Kamerton/Kamerton5_0/README.md

# Kamerton5_0 

Проект тестирования модуля Камертон
