Kamerton/Kamerton5_0/Adio1-v5Csch.pdf

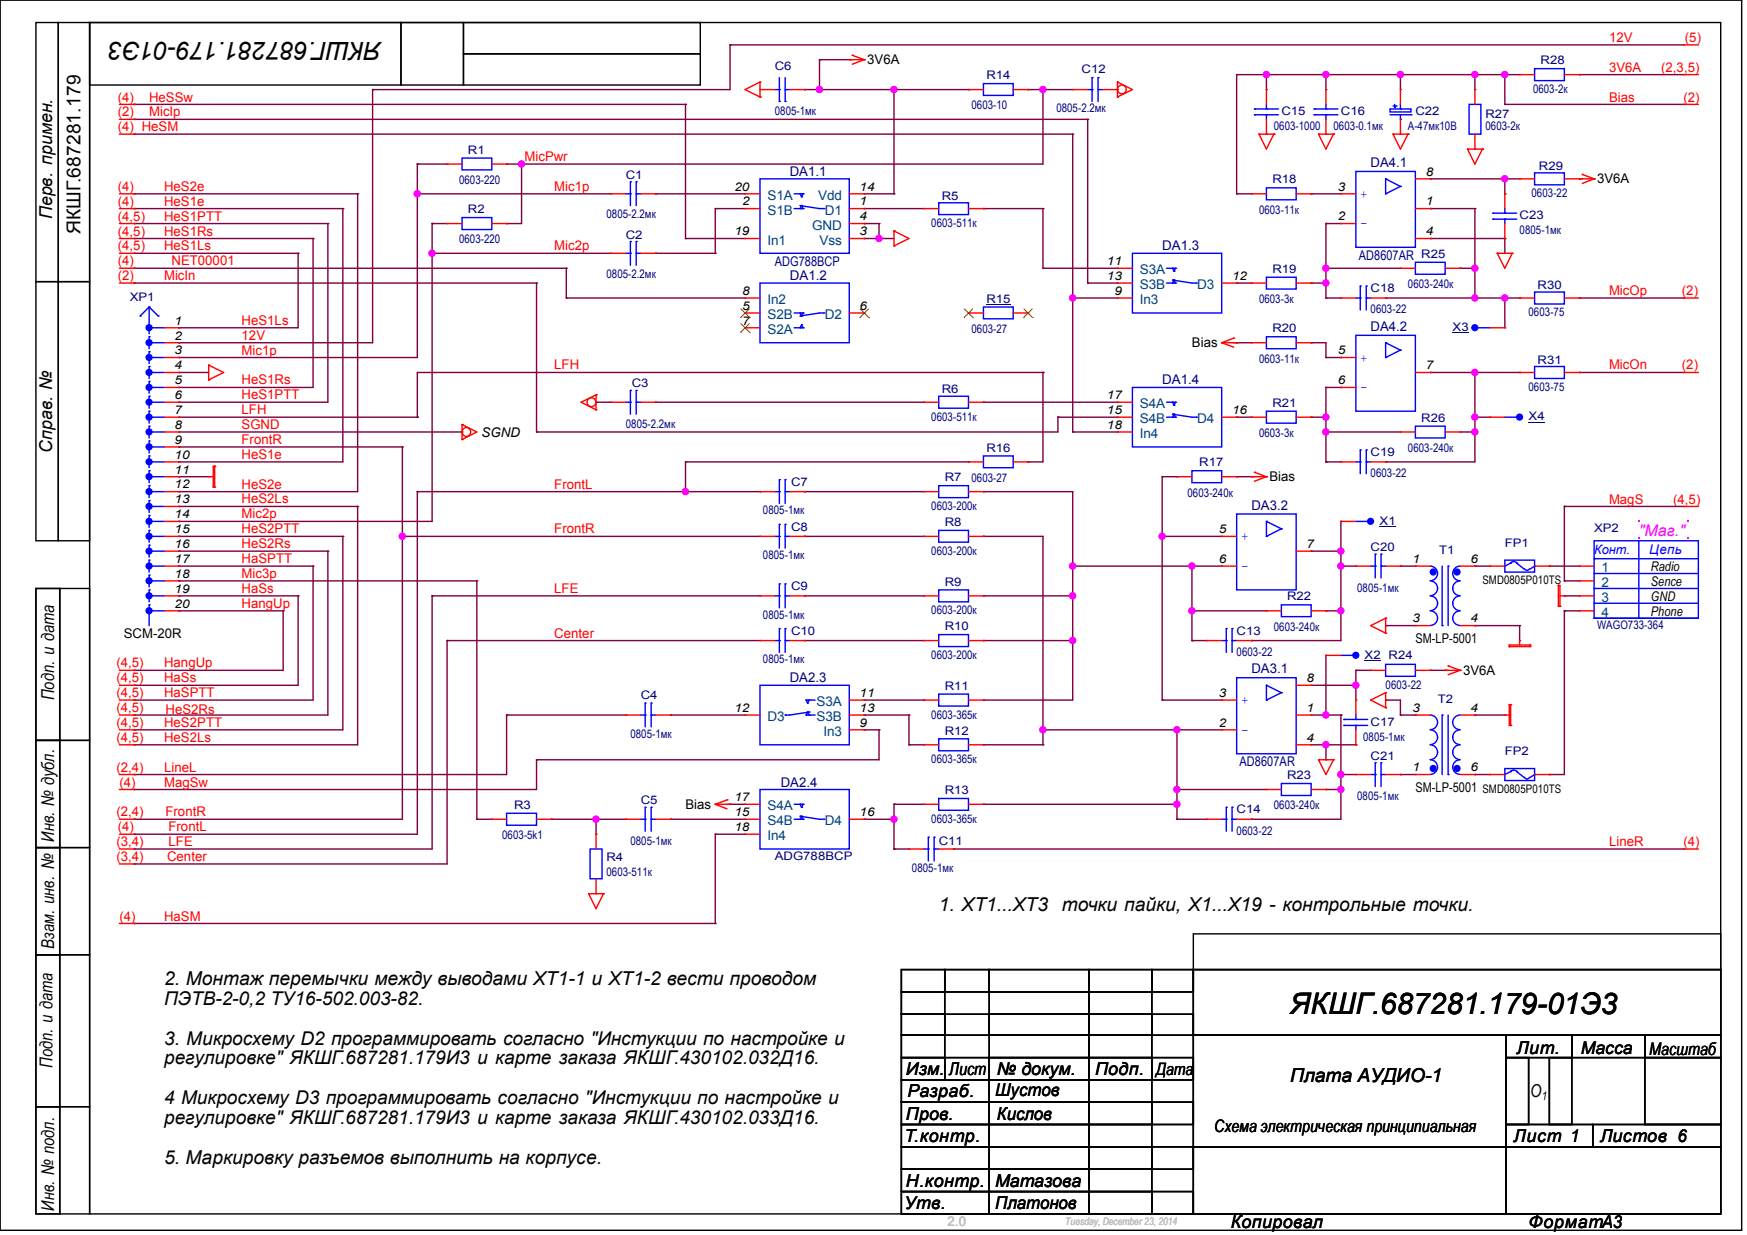
[picture p13: page 1]

Подп. и дата Инв. № дубл. Взам. инв. № Инв. № подл. Подп. и дата

1. XT1...XT3 точки пайки, Х1...Х19 - контрольные точки.

2. Монтаж перемычки между выводами XT1-1 и ХТ1-2 вести проводом
ПЭТВ-2-0,2 ТУ16-502.003-82.

3. Микросхему D2 программировать согласно "Инстукции по настройке и
регулировке" ЯКШГ.687281.179И3 и карте заказа ЯКШГ.430102.032Д16.

4 Микросхему D3 программировать согласно "Инстукции по настройке и
регулировке" ЯКШГ.687281.179И3 и карте заказа ЯКШГ.430102.033Д16.

5. Маркировку разъемов выполнить на корпусе.

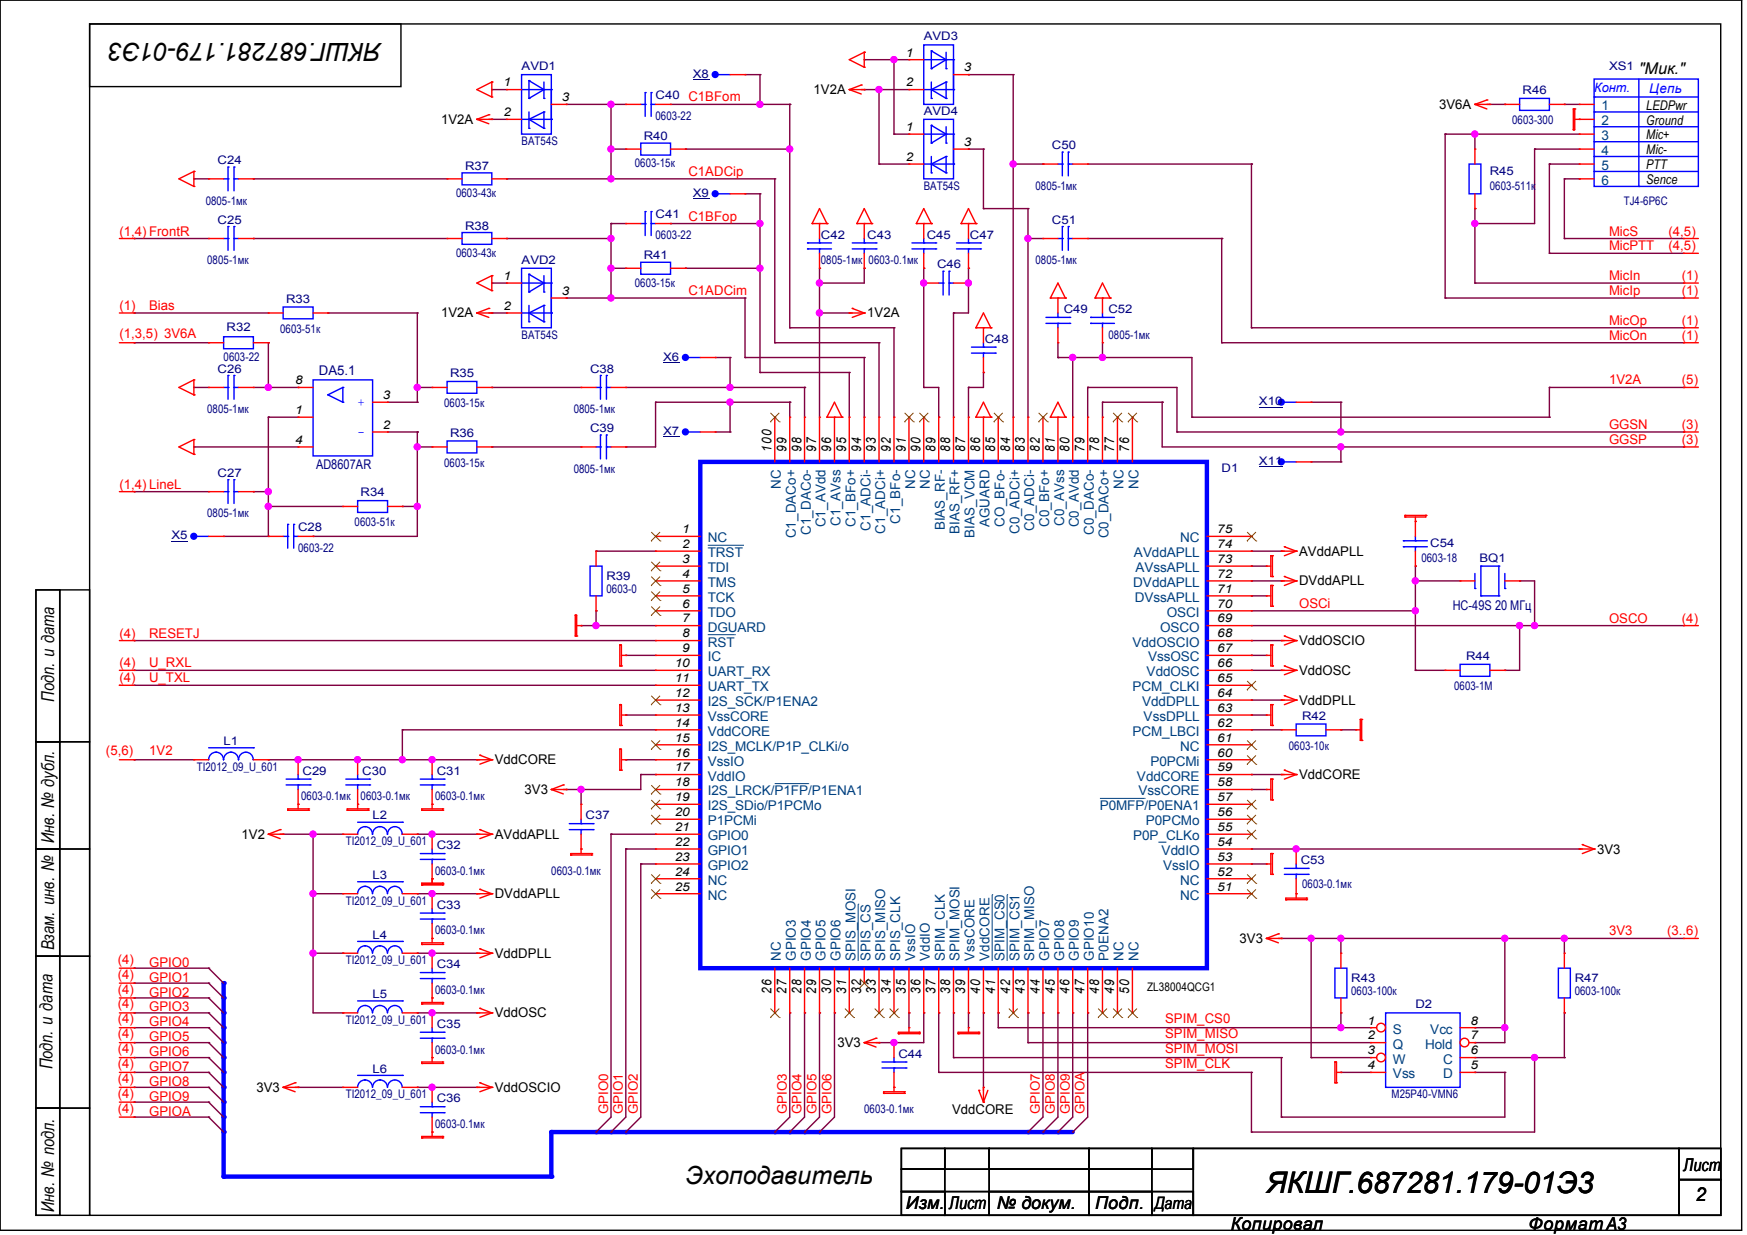
[picture p14: page 2]

Подп. и дата Инв. № дубл. Взам. инв. № Инв. № подл. Подп. и дата

Изм. Лист № докум. Подп. Дата

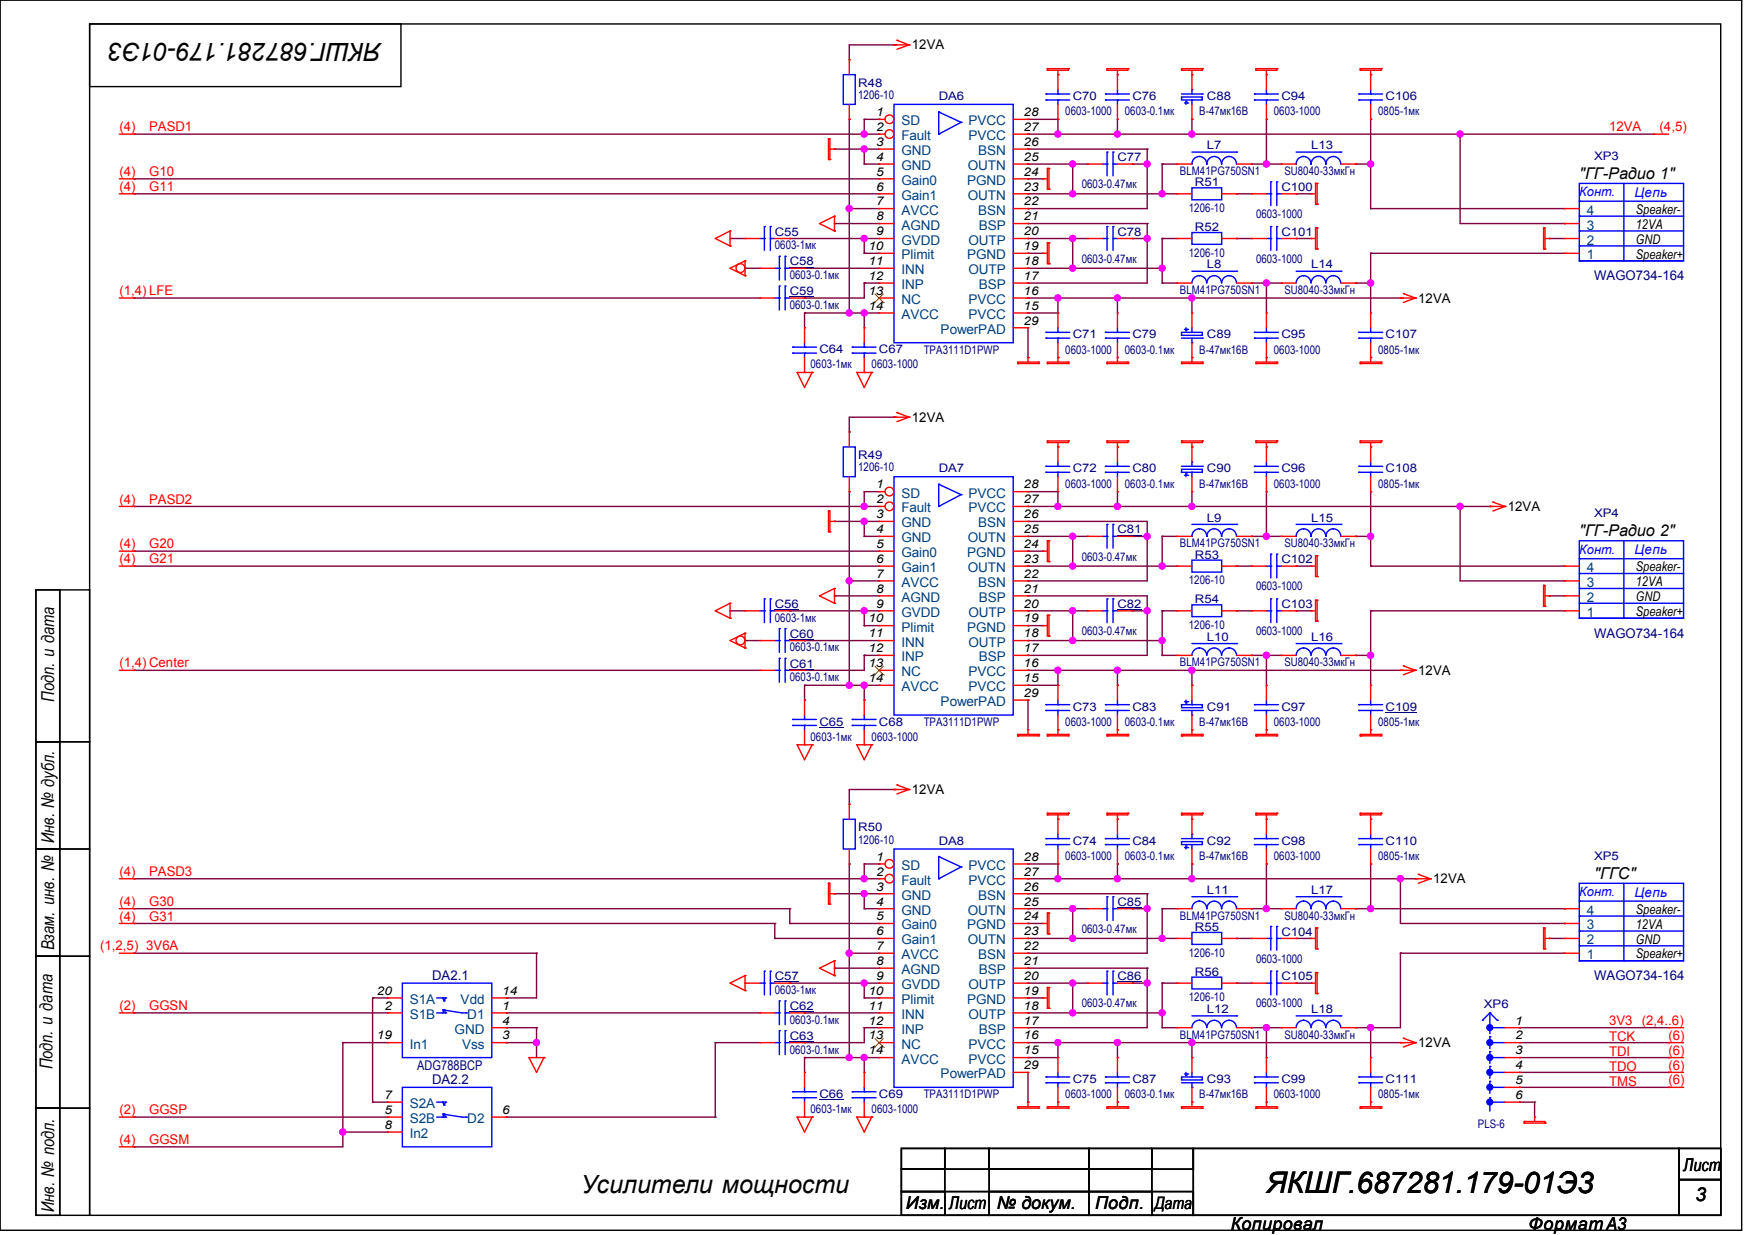
[picture p15: page 3]

Подп. и дата Инв. № дубл. Взам. инв. № Инв. № подл. Подп. и дата

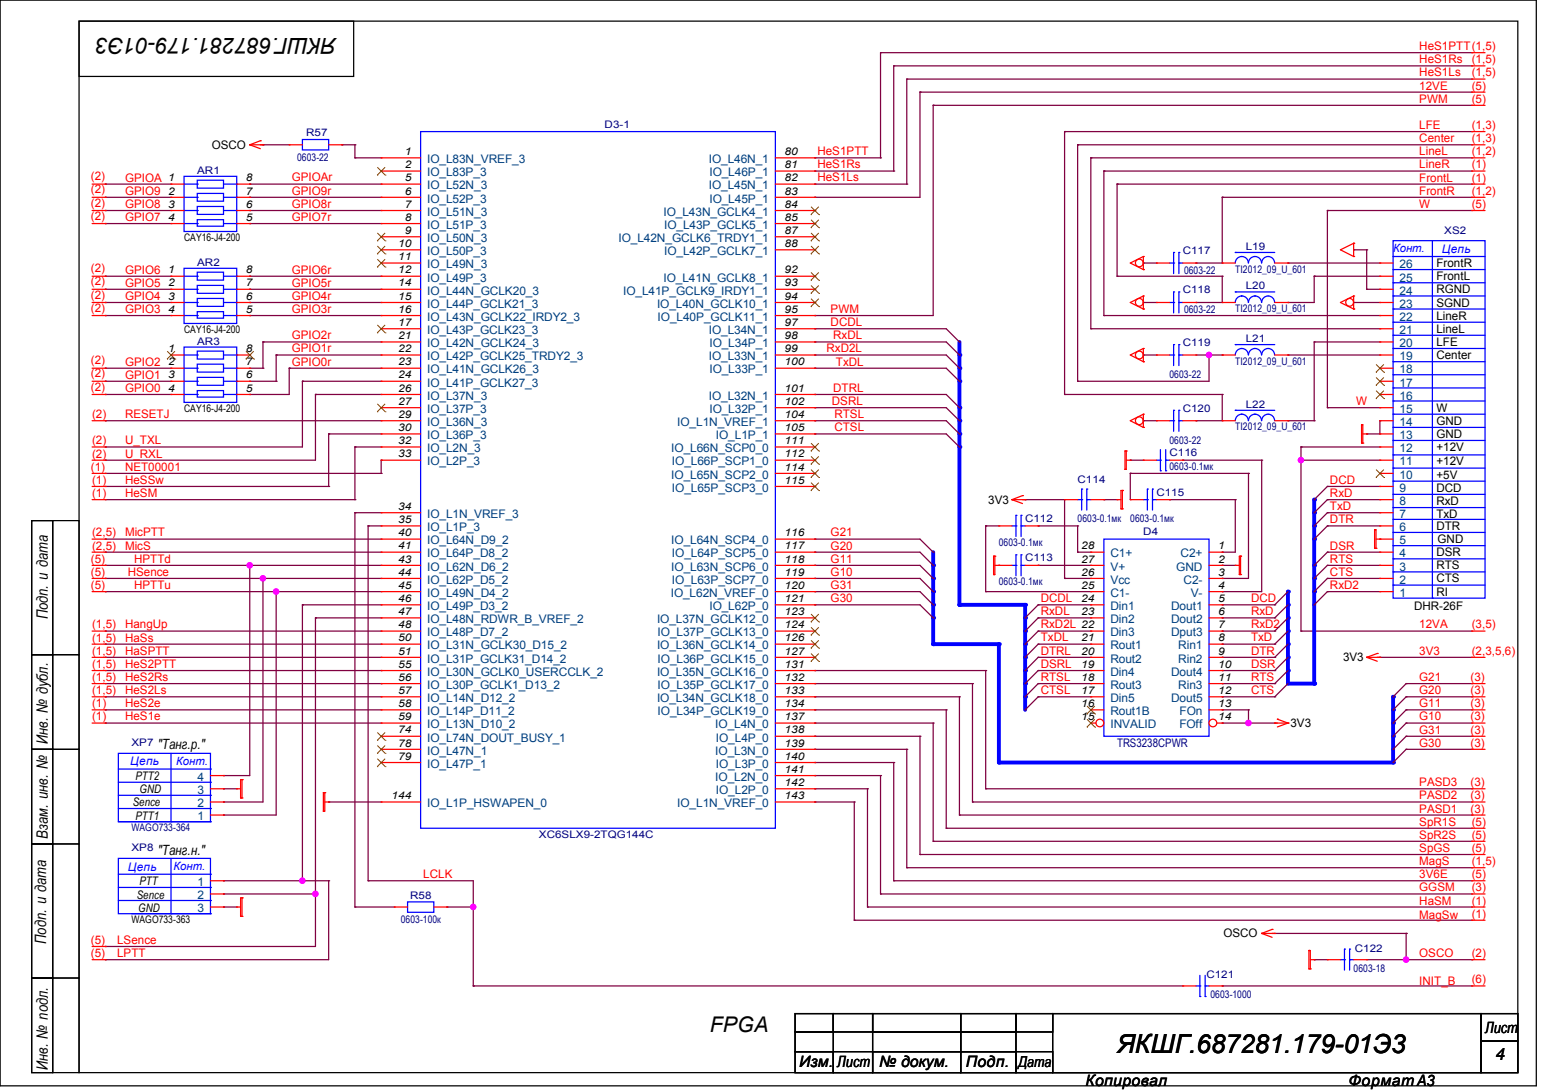
[picture p16: page 4]

Подп. и дата Инв. № дубл. Взам. инв. № Инв. № подл. Подп. и дата

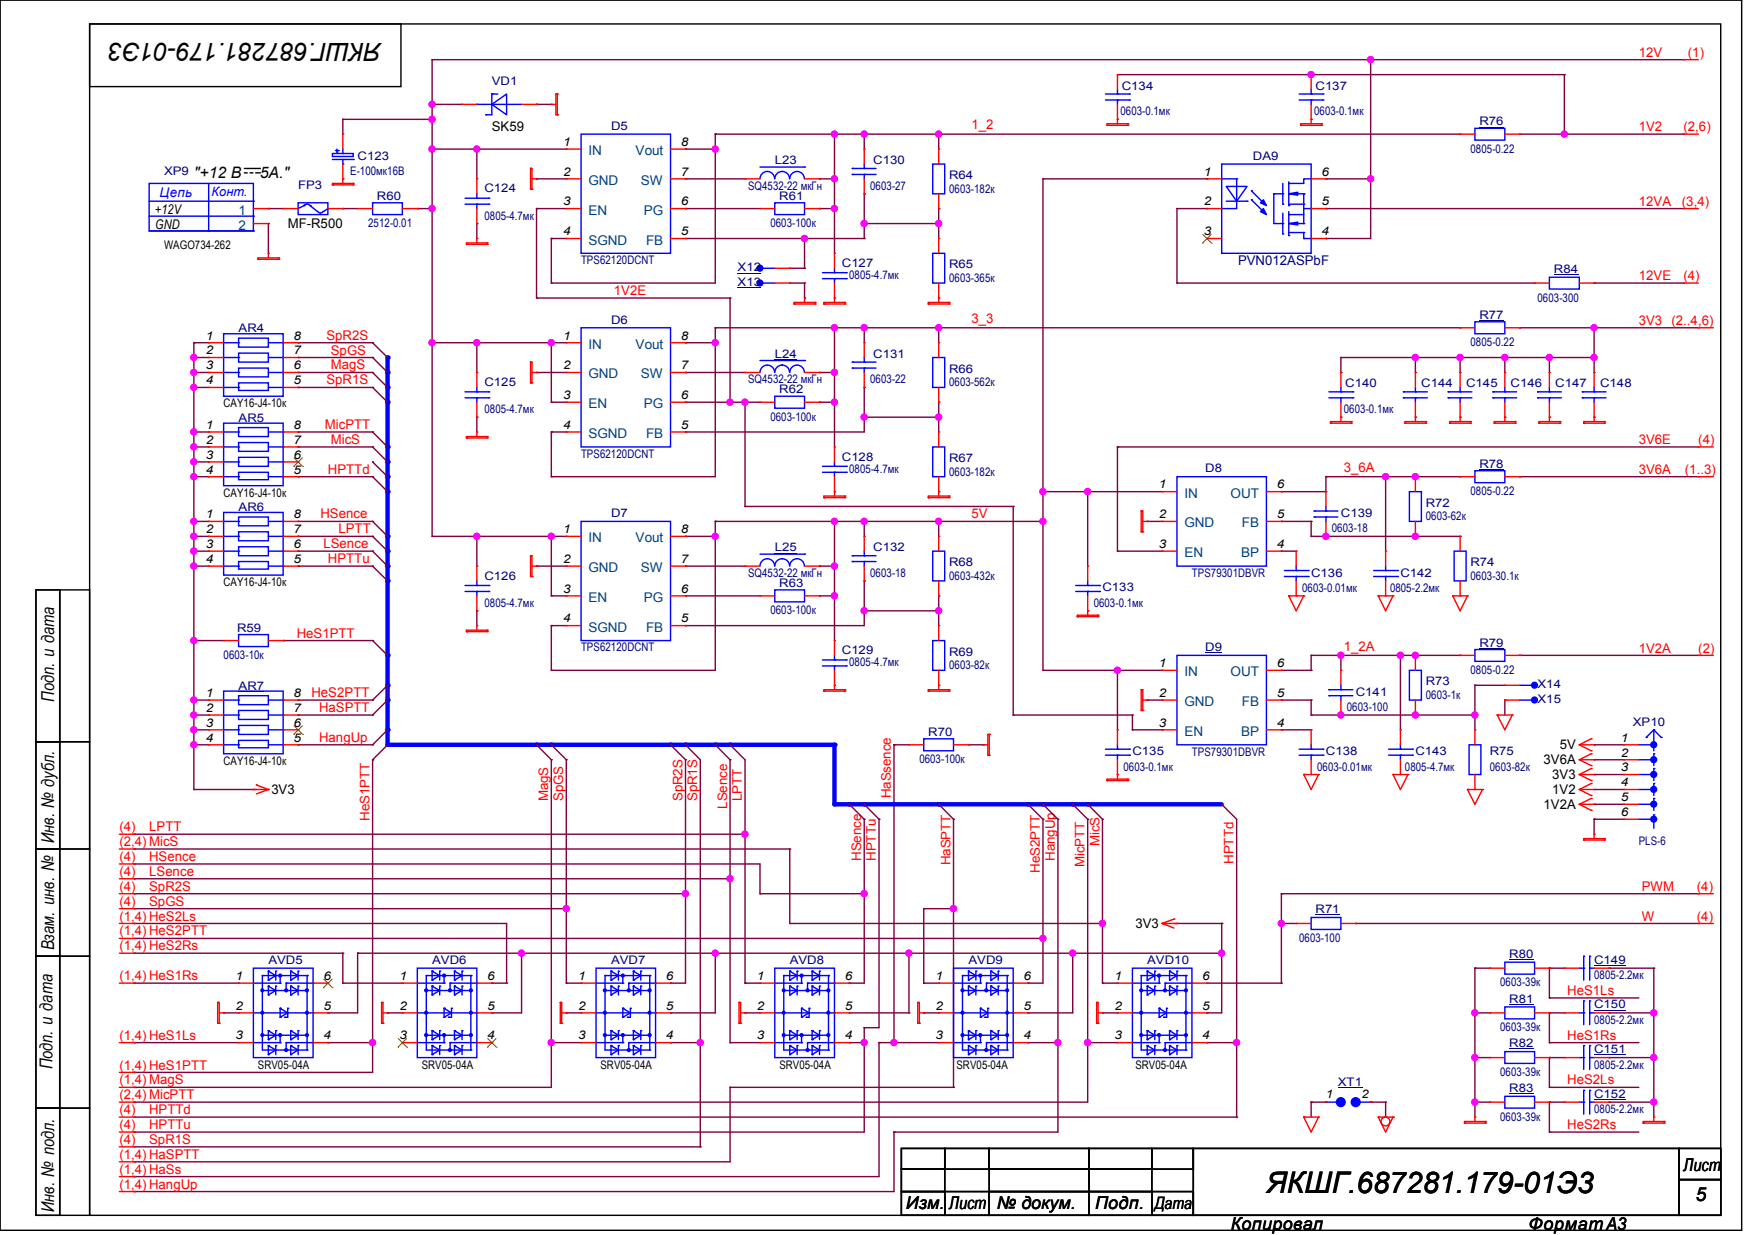
[picture p17: page 5]

Подп. и дата Инв. № дубл. Взам. инв. № Инв. № подл. Подп. и дата

1 | 1 | SPI_slave
XT1 | XT2

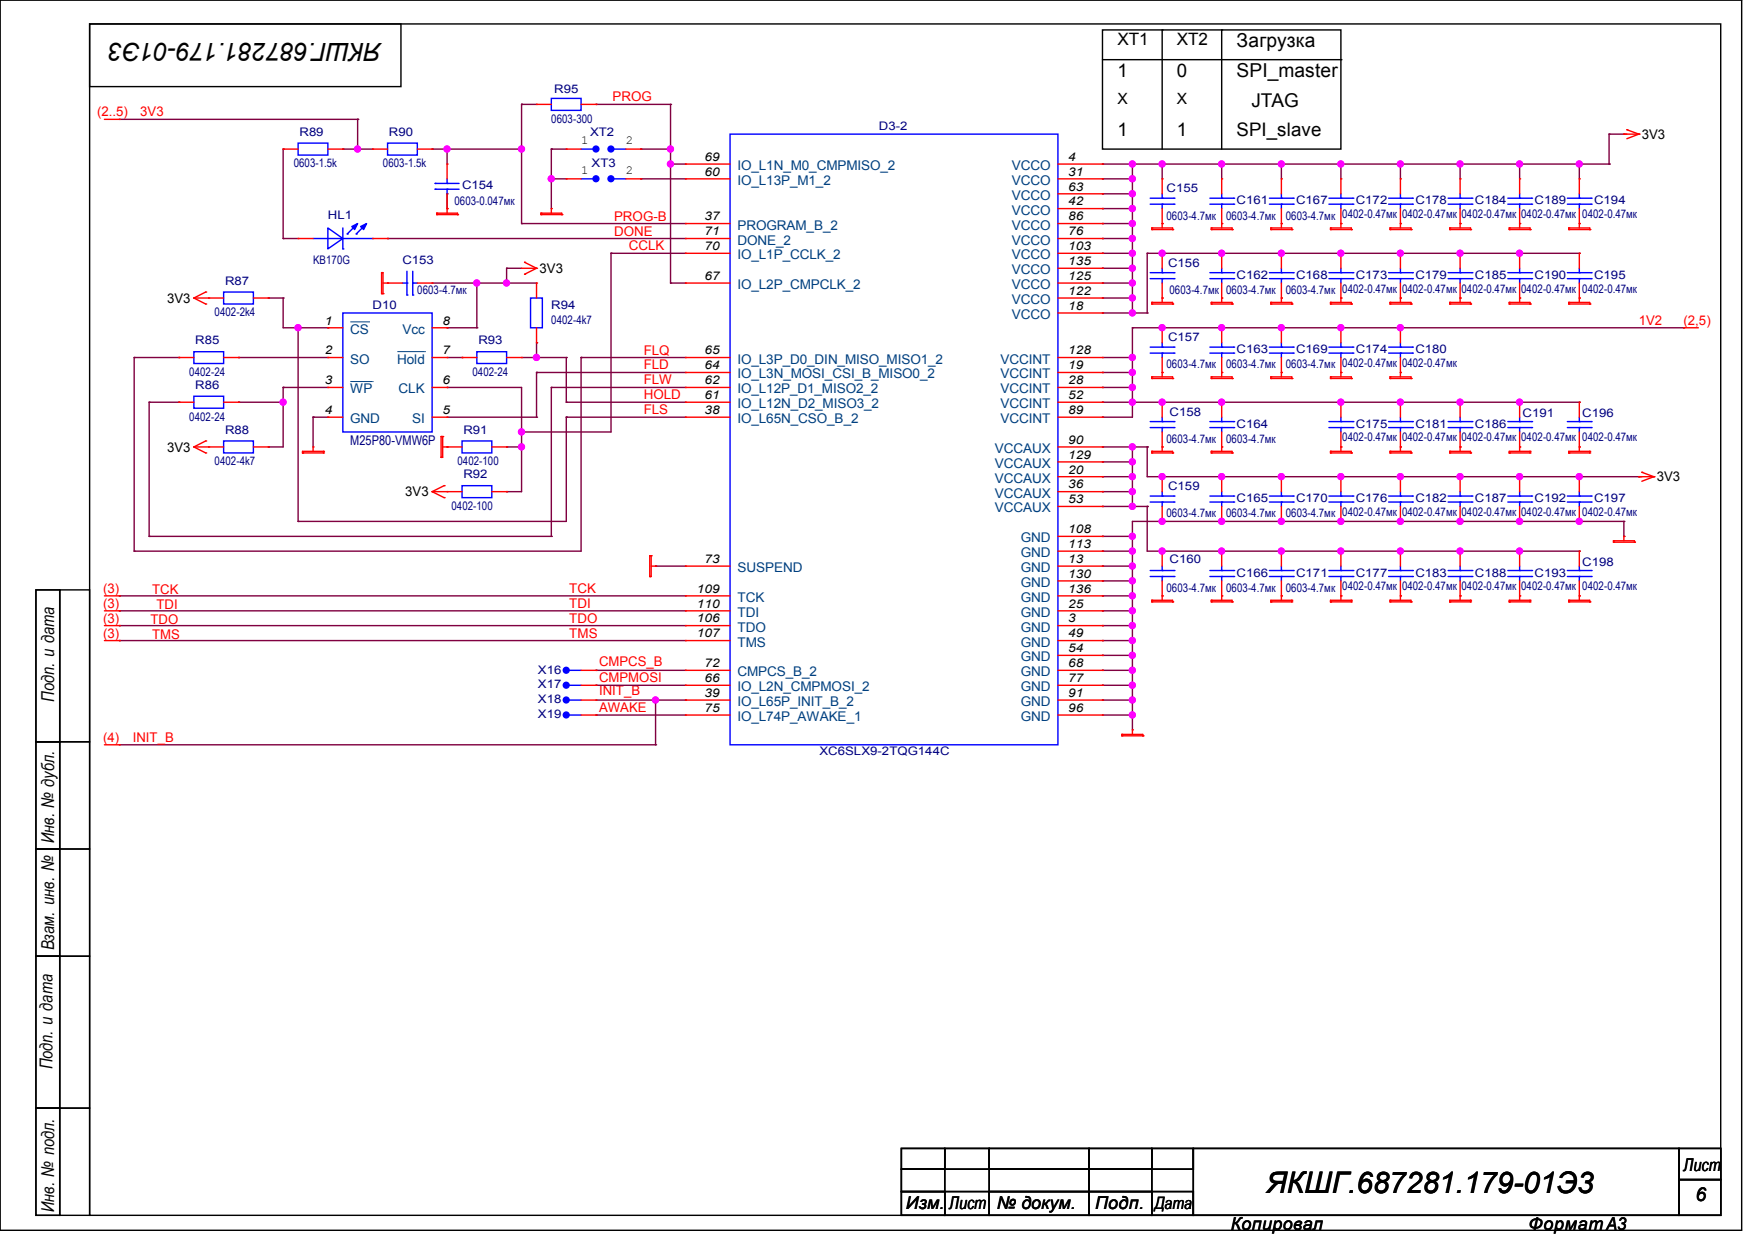
[picture p18: page 6]

Подп. и дата Инв. № дубл. Взам. инв. № Инв. № подл. Подп. и дата

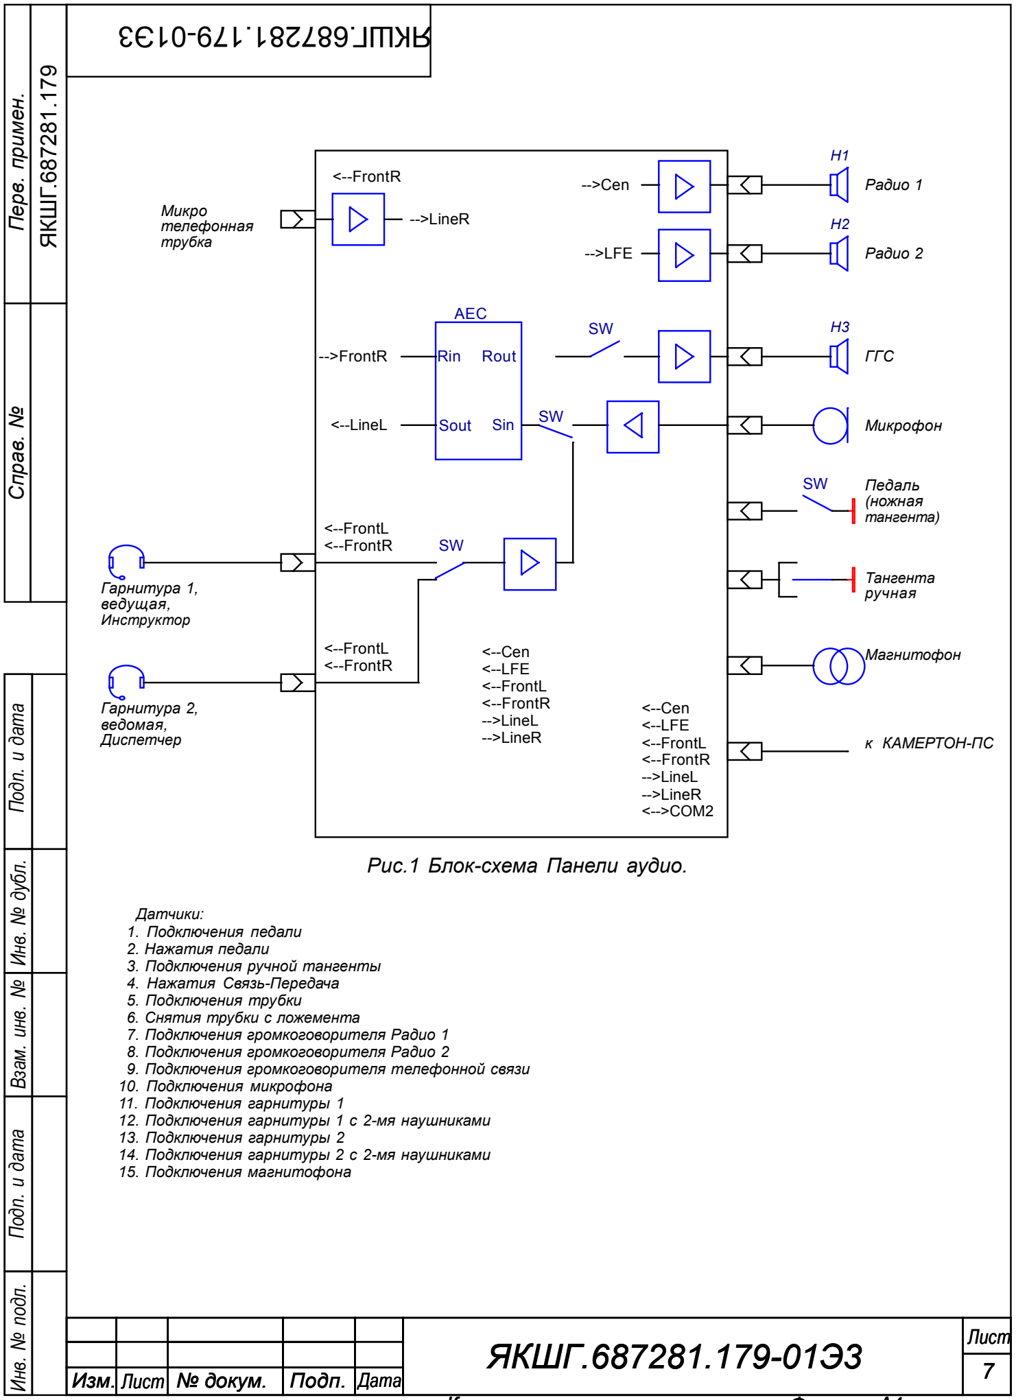
[picture p19: figure]
ЯКШГ.687281.179; -->LineL; <--FrontL <--FrontR; -->LineR; <--LFE; <--Cen; <-->COM2; -->Cen; -->LFE; <--LineL; -->FrontR; <--FrontR; Рис.1 Блок-схема Панели аудио.; Радио 1; Радио 2; ГГС; Микрофон; Магнитофон; Тангента ручная; Педаль (ножная тангента); к КАМЕРТОН-ПС; Микро телефонная трубка; Гарнитура 1, ведущая, Инструктор; Гарнитура 2, ведомая, Диспетчер; Rin; Rout; Sout; Sin; AEC; 15. Подключения магнитофона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

## Перв. примен. Справ. № Подп. и дата Инв. № дубл. Взам. инв. № Инв. № подл. Подп. и дата

9. Подключения громкоговорителя телефонной связи
12. Подключения гарнитуры 1 с 2-мя наушниками
14. Подключения гарнитуры 2 с 2-мя наушниками
