Kamerton/Kamerton5_0/(list of files, drawings)

Other design files:
Proteus Kamerton5_0/Mega2560 Kamerton5_0.pdsprj
Proteus Kamerton5_0/Mega2560 Kamerton5_1.pdsprj
Proteus Kamerton5_0/Mega2560 Kamerton5_2.pdsprj
Proteus Kamerton5_0/Mega2560 Kamerton5_3.pdsprj
Proteus Kamerton5_0/Mega2560 Kamerton5_4.pdsprj
Proteus Kamerton5_0/Mega2560 Kamerton5_5.pdsprj
Proteus Kamerton5_5mod/Mega2560 Kamerton5_5_mod.pdsprj
