Kamerton/Kamerton5_0/Kamerton5_0/Kamerton5_0.ino

/*

 Kamerton5_0.ino
 VisualStudio
 
 Программа тестирования модуля "Камертон" (Базовый вариант)
 Версия:      - 5_0
 Дата:        - 13.11.2015г.
 Организация: - ООО "Децима"
 Автор:       - Мосейчук А.В.
 Версия: Обновленная версия от 17.09.2015г. Новая плата с учетом добавления 
 высоковольтного  модуля для испытания на пробой.
 Реализовано:
 -
 - прерывание 30мс,
 - передача/прием по СОМ порту,
 - подсчет контролных сумм, связь с Камертоном, 
 - Расширение MCP23017
 - модуль реле, 
 - чтение всех портов, 
 - подключен звуковой генератор
 - Подключена SD память
 - подключены часы, память, 
 */


#include <SPI.h>
#include <SdFat.h>
#include <SdFatUtil.h>
#include <Wire.h> 
#include <RTClib.h>
#include <MsTimer2.h> 
#include <modbus.h>
#include <modbusDevice.h>
#include <modbusRegBank.h>
#include <modbusSlave.h>
#include "MCP23017.h"
#include <avr/pgmspace.h>
#include <AH_AD9850.h>
#include <avr/wdt.h>



//CLK - D6, FQUP - D7,  BitData - D8, RESET - D9
//AH_AD9850(int CLK, int FQUP, int BitData, int RESET);
//AH_AD9850 AD9850(6, 7, 8, 9);
AH_AD9850 AD9850(23, 25, 27, 29);


#define  ledPin13  13                               // Назначение светодиодов на плате
#define  ledPin12  12                               // Назначение светодиодов на плате
#define  ledPin11  11                               // Назначение светодиодов на плате
#define  ledPin10  10                               // Назначение светодиодов на плате
#define  Front_led_Blue 14                          // Назначение светодиодов на передней панели
#define  Front_led_Red  15                          // Назначение светодиодов на передней панели

//+++++++++++++++++++++++++++++ Внешняя память +++++++++++++++++++++++++++++++++++++++
int deviceaddress        = 80;                      // Адрес микросхемы памяти
unsigned int eeaddress   =  0;                      // Адрес ячейки памяти
byte hi;                                            // Старший байт для преобразования числа
byte low;                                           // Младший байт для преобразования числа


//  Порты управления платой Камертон
#define DTR  8                                      // DTR out выходной сигнал  сформировать 0 для старта
#define RTS  9                                      // RTS out выходной сигнал   
#define CTS  5                                      // CTS in  входной сигнал  флаг нажатия тангенты контролировать!!!!
#define DSR  6                                      // DSR in  входной сигнал  флаг нажатия "Связь - передача"
#define DCD  7                                      // DCD in  входной сигнал  флаг снятия трубки с ложемента 


//  Порты управления платой Arduino Nano
#define  kn1Nano   34                               // Назначение кнопок управления Nano генератор качения
#define  kn2Nano   36                               // Назначение кнопок управления Nano генератор 1000 гц
#define  kn3Nano   38                               // Назначение кнопок управления Nano генератор 2000 гц
#define  InNano12  40                               // Назначение входов - индикация генератор 1000 или 2000 гц
#define  InNano13  39                               // Назначение входов - индикация генератор качения 




//+++++++++++++++++++++++ Настройка электронного резистора +++++++++++++++++++++++++++++++++++++
#define address_AD5252   0x2F                       // Адрес микросхемы AD5252  
#define control_word1    0x07                       // Байт инструкции резистор №1
#define control_word2    0x87                       // Байт инструкции резистор №2
byte resistance        = 0x00;                      // Сопротивление 0x00..0xFF - 0Ом..100кОм
//byte level_resist      = 0;                       // Байт считанных данных величины резистора
//-----------------------------------------------------------------------------------------------
unsigned int volume1     = 0;                       //
unsigned int volume_max  = 0;                       //
unsigned int volume_min  = 0;                       //
unsigned int volume_fact = 0;                       //
unsigned int Array_volume[260];                     //
unsigned int Array_min[40];                         //
unsigned int Array_max[40];                         //
unsigned int volume_porog_D = 40;                   // Максимальная величина порога при проверке исправности FrontL,FrontR
unsigned int volume_porog_L = 200;                  // Минимальная величина порога при проверке исправности FrontL,FrontR
float voltage ;
//float voltage_test = 0.60;                        // порог величины синусоиды звука
unsigned int  voltage10 ;
unsigned long number_audio = 0;   


#define FASTADC 1                                   // Ускорение считывания аналогового сигнала
// defines for setting and clearing register bits
#ifndef cbi
#define cbi(sfr, bit) (_SFR_BYTE(sfr) &= ~_BV(bit))
#endif
#ifndef sbi
#define sbi(sfr, bit) (_SFR_BYTE(sfr) |= _BV(bit))
#endif


//***************************** Назначение аналоговых входов   ****************************************
int analog_tok            = 0;       //   Измерение тока питания платы Камертон
int analog_12V            = 1;       //   Измерение напряжения питания 12в. платы Камертон
int analog_tok_x10        = 2;       //   Измерение тока питания платы Камертон х 10
int analog_mag_radio      = 3;       //
int analog_mag_phone      = 4;       //
int analog_gg_radio1      = 5;       //
int analog_gg_radio2      = 6;       //
int analog_ggs            = 7;       //
int analog_LineL          = 8;       //
int analog_LineR          = 9;       //
int analog_FrontL         = 10;       //
int analog_FrontR         = 11;       //
int analog_W              = 12;       //
int analog_13             = 13;       // Измерение напряжения питания  12в.на разъемах  платы Камертон
int analog_14             = 14;       // Измерение напряжения питания  12в.на разъемах  платы Камертон
int analog_3_6            = 15;       // Измерение напряжения питания 3,6в. на разъемах платы Камертон

//-----------------------------------------------------------------------------------
bool portFound = false;
byte inputByte_0;
byte inputByte_1;
byte inputByte_2;
byte inputByte_3;
byte inputByte_4;
uint32_t logTime = 0;
int32_t diff = 0;

bool blink_red = false;
//************************************************************************************************

RTC_DS1307 RTC;                                     // define the Real Time Clock object

//-----------------------------------------------------------------------------------------------

uint8_t second = 0;       //Initialization time
uint8_t minute = 0;
uint8_t hour   = 0;
uint8_t dow    = 1;
uint8_t day    = 1;
uint8_t month  = 1;
uint16_t year  = 15 ;

//------------------------------------------------------------------------------------------------------------
MCP23017 mcp_Out1;                                  // Назначение портов расширения MCP23017  4 A - Out, B - Out
MCP23017 mcp_Out2;                                  // Назначение портов расширения MCP23017  6 A - Out, B - Out
MCP23017 mcp_Analog;                                // Назначение портов расширения MCP23017  5 A - Out, B - In
//----------------------------------------------------------------------------------------------
const int adr_reg_ind_CTS      PROGMEM           = 10081;        // Адрес флагa индикации состояния сигнала CTS
const int adr_reg_ind_DSR      PROGMEM           = 10082;        // Адрес флагa индикации состояния сигнала DSR
const int adr_reg_ind_DCD      PROGMEM           = 10083;        // Адрес флагa индикации состояния сигнала DCD

// **************** Адреса внешней памяти для хранения даты. Применяется приформировании имени файла *************
//const int adr_temp_day         PROGMEM           = 240;          // Адрес хранения переменной день
//const int adr_temp_mon         PROGMEM           = 241;          // Адрес хранения переменной месяц
//const int adr_temp_year        PROGMEM           = 242;          // Адрес хранения переменной год  
//const int adr_file_name_count  PROGMEM           = 243;          // Адрес хранения переменной счетчика номера файла
//------------------------------------------------------------------------------------------------------------------
int regcount_err        = 0;                                     // Переменная для хранения всех ошибок
	//	hi=highByte(n_str_electro);
	//	low=lowByte(n_str_electro);

//++++++++++++++++++++++ Работа с файлами +++++++++++++++++++++++++++++++++++++++
//#define chipSelect SS
#define chipSelect 49   // Основной
SdFat sd;
File myFile;
SdFile file;
//Sd2Card card;
//
//uint32_t cardSizeBlocks;
//uint16_t cardCapacityMB;
//
//// cache for SD block
//cache_t cache;


// созданы переменные, использующие функции библиотеки SD utility library functions: +++++++++++++++
// Change spiSpeed to SPI_FULL_SPEED for better performance
// Use SPI_QUARTER_SPEED for even slower SPI bus speed
const uint8_t spiSpeed = SPI_HALF_SPEED;


//++++++++++++++++++++ Назначение имени файла ++++++++++++++++++++++++++++++++++++++++++++
//const uint32_t FILE_BLOCK_COUNT = 256000;
// log file base name.  Must be six characters or less.
#define FILE_BASE_NAME "150101"
const uint8_t BASE_NAME_SIZE = sizeof(FILE_BASE_NAME) - 1;
char fileName[13]            = FILE_BASE_NAME "00.TXT";
char fileName_p[13];
char fileName_F[13];
//------------------------------------------------------------------------------

char c;  // Для ввода символа с ком порта

// Serial output stream
ArduinoOutStream cout(Serial);
char bufferSerial2[128];  

//*********************Работа с именем файла ******************************

//byte file_name_count = 0;
char str_day_file[3];
char str_day_file0[3];
char str_day_file10[3];
char str_mon_file[3];
char str_mon_file0[3];
char str_mon_file10[3];
char str_year_file[3];

char str0[10];
char str1[10];
char str2[10];

//+++++++++++++++++++++ Установки прерывания +++++++++++++++++++++++++++++++

unsigned int sampleCount1 = 0;

//+++++++++++++++++++ MODBUS ++++++++++++++++++++++++++++++++++++++++++++++++++++++++++

modbusDevice regBank;
//Create the modbus slave protocol handler
modbusSlave slave;

//byte regs_in[5];                                    // Регистры работы с платой Камертон CPLL
byte regs_out[4];                                   // Регистры работы с платой Камертон
byte regs_crc[1];                                   // Регистры работы с платой Камертон контрольная сумма
byte regs_temp = 0;
byte regs_temp1 = 0;
byte Stop_Kam = 0;                                  // Флаг индикации чтения инф. из Камертона
bool prer_Kmerton_On = true;                        // Флаг разрешение прерывания Камертон
bool test_repeat     = true;                        // Флаг повторения теста
volatile bool prer_Kmerton_Run = false;             // Флаг разрешение прерывания Камертон
#define BUFFER_SIZEK 64                             // Размер буфера Камертон не более 128 байт
#define BUFFER_SIZEKF 128                           // Размер буфера Serial2 не более 128 байт
unsigned char bufferK;                              // Счетчик количества принимаемых байт

//+++++++++++++++++++++++++++++++++++++++++++++++++++++++++++++++++++++++++++++++++++++

// Текущее время 
const unsigned int adr_kontrol_day        PROGMEM      = 40046; // адрес день
const unsigned int adr_kontrol_month      PROGMEM      = 40047; // адрес месяц
const unsigned int adr_kontrol_year       PROGMEM      = 40048; // адрес год
const unsigned int adr_kontrol_hour       PROGMEM      = 40049; // адрес час
const unsigned int adr_kontrol_minute     PROGMEM      = 40050; // адрес минута
const unsigned int adr_kontrol_second     PROGMEM      = 40051; // адрес секунда

// Установка времени в контроллере
const unsigned int adr_set_kontrol_day    PROGMEM      = 40052;   // адрес день
const unsigned int adr_set_kontrol_month  PROGMEM      = 40053;   // адрес месяц
const unsigned int adr_set_kontrol_year   PROGMEM      = 40054;   // адрес год
const unsigned int adr_set_kontrol_hour   PROGMEM      = 40055;   // адрес час
const unsigned int adr_set_kontrol_minute PROGMEM      = 40056;   // адрес минута

// Время старта теста
const unsigned int adr_Mic_Start_day      PROGMEM      = 40096; // адрес день
const unsigned int adr_Mic_Start_month    PROGMEM      = 40097; // адрес месяц
const unsigned int adr_Mic_Start_year     PROGMEM      = 40098; // адрес год
const unsigned int adr_Mic_Start_hour     PROGMEM      = 40099; // адрес час
const unsigned int adr_Mic_Start_minute   PROGMEM      = 40100; // адрес минута
const unsigned int adr_Mic_Start_second   PROGMEM      = 40101; // адрес секунда
// Время окончания теста
const unsigned int adr_Mic_Stop_day       PROGMEM       = 40102; // адрес день
const unsigned int adr_Mic_Stop_month     PROGMEM       = 40103; // адрес месяц
const unsigned int adr_Mic_Stop_year      PROGMEM       = 40104; // адрес год
const unsigned int adr_Mic_Stop_hour      PROGMEM       = 40105; // адрес час
const unsigned int adr_Mic_Stop_minute    PROGMEM       = 40106; // адрес минута
const unsigned int adr_Mic_Stop_second    PROGMEM       = 40107; // адрес секунда

// Продолжительность выполнения теста
const unsigned int adr_Time_Test_day      PROGMEM       = 40108; // адрес день
const unsigned int adr_Time_Test_hour     PROGMEM       = 40109; // адрес час
const unsigned int adr_Time_Test_minute   PROGMEM       = 40110; // адрес минута
const unsigned int adr_Time_Test_second   PROGMEM       = 40111; // адрес секунда

const unsigned int adr_reg_temp_year      PROGMEM       = 40112; // Регистр хранения переменной год  
const unsigned int adr_reg_temp_mon       PROGMEM       = 40113; // Регистр хранения переменной месяц
const unsigned int adr_reg_temp_day       PROGMEM       = 40114; // Регистр хранения переменной день 
const unsigned int adr_reg_file_name      PROGMEM       = 40115; // Регистр хранения счетчик файлов  
const unsigned int adr_reg_file_tek       PROGMEM       = 40116; // Регистр хранения счетчик файлов  

const unsigned int adr_control_command    PROGMEM       = 40120; // Адрес передачи комманд на выполнение 
const unsigned int adr_reg_count_err      PROGMEM       = 40121; // Адрес счетчика всех ошибок

const unsigned int adr_set_time           PROGMEM       = 36;    // адрес флаг установки

//------------------------- Уровни пороговых значений сигналов при тестировании устройств--------------------------------------
//++++++++++++++++++++++++++++ Заводские установки уровней порогов +++++++++++++++++++++++++++++++++++++

// Адреса внешней памяти для хранения порогов уровней измерения сигналов

const  int adr_porog_instruktor            = 0;     // 19 адресов 
const  int adr_porog_dispatcher            = 20;    // 19 адресов 
const  int adr_porog_MTT                   = 40;    // 21 адресов 
const  int adr_porog_GGS                   = 170;    // 29 адресов 
const  int adr_porog_Radio1                = 100;   // 20 адресов 
const  int adr_porog_Radio2                = 120;   // 20 адресов 
const  int adr_porog_Microphone            = 140;   //  
// end                                     = 160

//Новые пороги две ячейки, 2 байта
const  int adr_int_porog_instruktor            = 200;     // 19 адресов 
const  int adr_int_porog_dispatcher            = 250;    // 19 адресов 
const  int adr_int_porog_MTT                   = 300;    // 21 адресов 
const  int adr_int_porog_GGS                   = 350;    // 29 адресов 
const  int adr_int_porog_Radio1                = 420;   // 20 адресов 
const  int adr_int_porog_Radio2                = 460;   // 20 адресов 
const  int adr_int_porog_Microphone            = 500;   //
//end                                            550;


byte por_buffer[30] ;

//const byte porog_instruktor[]    PROGMEM  = {30,30,35,35,35,35,35,35,35,35,35,150,150,35,35,35,35,35,35,35,254};
const byte porog_instruktor[]    PROGMEM  = {
		 //++++++++++++++++  Test headset instructor ++++++++++++++++++++++++++++
100,			// 0                          // resistor(1, 30);     Установить уровень сигнала 30 мв
100,			// 1                          // resistor(2, 30);     Установить уровень сигнала 30 мв
15,			// 2                          // measure_vol_min(analog_FrontL,   40230,230,35);  уровень сигнала на выходе FrontL  
15,			// 3                          // measure_vol_min(analog_FrontR,   40231,231,35);  уровень сигнала на выходе FrontR
15,			// 4                          // measure_vol_min(analog_LineL,    40232,232,35);  уровень сигнала на выходе LineL 
15,			// 5                          // measure_vol_min(analog_LineR,    40233,233,35);  уровень сигнала на выходе LineR
15,			// 6                          // measure_vol_min(analog_mag_radio,40234,234,35);  уровень сигнала на выходе mag radio 
15,			// 7                          // measure_vol_min(analog_mag_phone,40235,235,35);  уровень сигнала на выходе mag phone
15,			// 8                          // measure_vol_min(analog_ggs,      40236,236,35);  уровень сигнала на выходе GGS 
15,			// 9                          // measure_vol_min(analog_gg_radio1,40237,237,35);  уровень сигнала на выходе GG Radio1
15,			// 10                         // measure_vol_min(analog_gg_radio2,40238,238,35);  уровень сигнала на выходе GG Radio2 
			//---------- Сигнал на вход подан ---------------------
160,    	// 11                         // measure_vol_max(analog_LineL,    40224,224,150); уровень сигнала на выходе LineL
160,		// 12                         // measure_vol_max(analog_mag_phone,40226,226,150); уровень сигнала на выходе mag phone 
15, 		// 13                         // measure_vol_min(analog_FrontL,   40230,230,35);  уровень сигнала на выходе FrontL 
15,			// 14                         // measure_vol_min(analog_FrontR,   40231,231,35);  уровень сигнала на выходе FrontR 
15,			// 15                         // measure_vol_min(analog_LineR,    40233,233,35);  уровень сигнала на выходе LineR 
15,			// 16                         // measure_vol_min(analog_ggs,      40236,236,35);  уровень сигнала на выходе GGS 
15,			// 17                         // measure_vol_min(analog_gg_radio1,40237,237,35);  уровень сигнала на выходе GG Radio1
15  		// 18                         // measure_vol_min(analog_gg_radio2,40238,238,35);  уровень сигнала на выходе GG Radio2
};
  
const byte  porog_dispatcher[]    PROGMEM = {

		//	+++++++++++++Test headset dispatcher ++++++++++++++++++++++++++++++
100,			// 0                          // resistor(1, 30);   Установить уровень сигнала 30 мв
100,			// 1                          // resistor(2, 30);   Установить уровень сигнала 30 мв
15,			// 2                          // measure_vol_min(analog_FrontL,   40240,240,35);  уровень сигнала на выходе FrontL 
15,			// 3                          // measure_vol_min(analog_FrontR,   40241,241,35);  уровень сигнала на выходе FrontR
15,			// 4                          // measure_vol_min(analog_LineL,    40242,242,35);  уровень сигнала на выходе LineL
15,			// 5                          // measure_vol_min(analog_LineR,    40243,243,35);  уровень сигнала на выходе LineR
15,			// 6                          // measure_vol_min(analog_mag_radio,40244,244,35);  уровень сигнала на выходе mag radio
15,			// 7                          // measure_vol_min(analog_mag_phone,40245,245,35);  уровень сигнала на выходе mag phone
15,			// 8                          // measure_vol_min(analog_ggs,      40246,246,35);  уровень сигнала на выходе GGS 
15,			// 9                          // measure_vol_min(analog_gg_radio1,40247,247,35);  уровень сигнала на выходе GG Radio1
15,			// 10                         // measure_vol_min(analog_gg_radio2,40248,248,35);  уровень сигнала на выходе GG Radio2 
			// ++++++++++++++++++++++++++++++++++++++++ Включить микрофон инструктора ++++++++++++++++++++++++++++++++++++++++++++++++++
160,		// 11                         // measure_vol_max(analog_LineL,    40227,227,200); уровень сигнала на выходе LineL
160,		// 12                         // measure_vol_max(analog_mag_phone,40229,229,200); уровень сигнала на выходе mag phone
15,			// 13                         // measure_vol_min(analog_FrontL,   40240,240,35);  уровень сигнала на выходе FrontL 
15,			// 14                         // measure_vol_min(analog_FrontR,   40241,241,35);  уровень сигнала на выходе FrontR 
15,			// 15                         // measure_vol_min(analog_LineR,    40243,243,35);  уровень сигнала на выходе LineR 
15,			// 16                         // measure_vol_min(analog_ggs,      40246,246,35);  уровень сигнала на выходе GGS
15,			// 17                         // measure_vol_min(analog_gg_radio1,40247,247,35);  уровень сигнала на выходе GG Radio1
15			// 18                         // measure_vol_min(analog_gg_radio2,40248,248,35);  уровень сигнала на выходе GG Radio2
};

const byte  porog_MTT[]    PROGMEM = {
	//++++++++++++++++++++++++++++++++++ Test MTT ++++++++++++++++++++++++++++++++++++++++++++++++++++++++
200,		// 0                          // resistor(1, 130);  Установить уровень сигнала 60 мв
200,		// 1                          // resistor(2, 130);  Установить уровень сигнала 60 мв
15,			// 2                          // measure_vol_min(analog_FrontL,    40250,250,35); уровень сигнала на выходе FrontL  
15,			// 3                          // measure_vol_min(analog_FrontR,    40251,251,35); уровень сигнала на выходе FrontR 
15,			// 4                          // measure_vol_min(analog_LineL,     40252,252,35); уровень сигнала на выходе LineL
15,			// 5                          // measure_vol_min(analog_LineR,     40253,253,35); уровень сигнала на выходе LineR
15,			// 6                          // measure_vol_min(analog_mag_radio, 40254,254,35); уровень сигнала на выходе mag radio
15,			// 7                          // measure_vol_min(analog_mag_phone, 40255,255,35); уровень сигнала на выходе mag phone
15,			// 8                          // measure_vol_min(analog_ggs,       40256,256,35); уровень сигнала на выходе GGS 
15,			// 9                          // measure_vol_min(analog_gg_radio1, 40257,257,35); уровень сигнала на выходе GG Radio1
15,			// 10                         // measure_vol_min(analog_gg_radio2, 40258,258,35); уровень сигнала на выходе GG Radio2 
			//++++++++++++++++++++++++++++++++++ Сигнал подан на вход МТТ ++++++++++++++++++++++++++++++++++++++++++++
15,			// 11                         // measure_vol_min(analog_FrontL,    40250,250,35); уровень сигнала на выходе FrontL
15,			// 12                         // measure_vol_min(analog_FrontR,    40251,251,35); уровень сигнала на выходе FrontR
15,			// 13                         // measure_vol_min(analog_mag_radio, 40254,254,35); уровень сигнала на выходе mag radio
15,			// 14                         // measure_vol_min(analog_ggs,       40256,256,35); уровень сигнала на выходе GGS
15,			// 15                         // measure_vol_min(analog_gg_radio1, 40257,257,35); уровень сигнала на выходе GG Radio1
15,			// 16                         // measure_vol_min(analog_gg_radio2, 40258,258,35); уровень сигнала на выходе GG Radio2 
150,		// 17                         // measure_vol_max(analog_LineL,    40260,260,35);  "Test MTT ** Signal LineL 
150,		// 18                         // measure_vol_max(analog_LineR,    40261,261,35);  "Test MTT ** Signal LineR 
15,         // 19                         // measure_vol_min(analog_ggs,       40256,256,por_buffer[19]);                    // Измерить уровень сигнала на выходе GGS       "Test MTT ** Signal GGS                                      OFF - ";
120			// 20                         // measure_vol_max(analog_mag_phone,40262,262,90);  уровень сигнала на выходе mag phone
};




const byte  porog_Microphone[]    PROGMEM = {
		//+++++++++++++++++++++++++++++++++ Test Microphone +++++++++++++++++++++++++++++++++++++++++++++++++++++++++++++++++++++++
150,		// 0                          // resistor(1, 200);  Установить уровень сигнала 60 мв
150,		// 1                          // resistor(2, 200);  Установить уровень сигнала 60 мв
15,			// 2                          // measure_vol_min(analog_FrontL,    40320,320,35); уровень сигнала на выходе FrontL
15,			// 3                          // measure_vol_min(analog_FrontR,    40321,321,35); уровень сигнала на выходе FrontR 
15,			// 4                          // measure_vol_min(analog_LineL,     40322,322,35); уровень сигнала на выходе LineL
15,			// 5                          // measure_vol_min(analog_LineR,     40323,323,35); уровень сигнала на выходе LineR
15,			// 6                          // measure_vol_min(analog_mag_radio, 40324,324,35); уровень сигнала на выходе mag radio
15,			// 7                          // measure_vol_min(analog_mag_phone, 40325,325,35); уровень сигнала на выходе mag phone
15,			// 8                          // measure_vol_min(analog_ggs,       40326,326,35); уровень сигнала на выходе GGS 
15,			// 9                          // measure_vol_min(analog_gg_radio1, 40327,327,35); уровень сигнала на выходе GG Radio1
15,			// 10                         // measure_vol_min(analog_gg_radio2, 40328,328,35); уровень сигнала на выходе GG Radio2
			//++++++++++++++++++++++++++++++++++ Сигнал подан на вход микрофона ++++++++++++++++++++++++
150,		// 11                         // measure_vol_max(analog_mag_phone, 40298,298,180);уровень сигнала на выходе mag phone
150,		// 12                         // measure_vol_max(analog_LineL,     40299,299,180);уровень сигнала на выходе "Test Microphone ** Signal LineL 
15,			// 13                         // measure_vol_min(analog_FrontL,    40320,320,35); уровень сигнала на выходе FrontL 
15,			// 14                         // measure_vol_min(analog_FrontR,    40321,321,35); уровень сигнала на выходе FrontR
15,			// 15                         // measure_vol_min(analog_LineR,     40323,323,35); уровень сигнала на выходе LineR
15,			// 16                         // measure_vol_min(analog_mag_radio, 40324,324,35); уровень сигнала на выходе mag radio 
15,			// 17                         // measure_vol_min(analog_ggs,       40326,326,35); уровень сигнала на выходе GGS
15,			// 18                         // measure_vol_min(analog_gg_radio1, 40327,327,35); уровень сигнала на выходе GG Radio1
15,         // 19                         // measure_vol_min(analog_gg_radio2, 40328,328,35); уровень сигнала на выходе GG Radio2
};

const byte  porog_GGS[]    PROGMEM = {
	//++++++++++++++++++++++++++++++++ Test GGS ++++++++++++++++++++++++++++++++++++++++++++++++++++++++++++++++++++++++++++++++
200,		//  0                         // resistor(1, 200); Установить уровень сигнала xx мв
200,		//  1                         // resistor(2, 200); Установить уровень сигнала xx мв
				//+++++++++++++++++++++++++++++++++++   Проверка отсутствия сигнала на выходах +++++++++++++++++++++++++++++++++++++++++++++++++++++++
35, 		//  2                         // measure_vol_min(analog_FrontL,    40280,280,35); уровень сигнала на выходе "Test GGS ** Signal FrontL 
35, 		//  3                         // measure_vol_min(analog_FrontR,    40281,281,35); уровень сигнала на выходе "Test GGS ** Signal FrontR        
35, 		//  4                         // measure_vol_min(analog_LineL,     40282,282,35); уровень сигнала на выходе "Test GGS ** Signal LineL 
35, 		//  5                         // measure_vol_min(analog_LineR,     40283,283,35); уровень сигнала на выходе "Test GGS ** Signal LineR 
35, 		//  6                         // measure_vol_min(analog_mag_radio, 40284,284,35); уровень сигнала на выходе "Test GGS ** Signal mag radio
35, 		//  7                         // measure_vol_min(analog_mag_phone, 40285,285,35); уровень сигнала на выходе "Test GGS ** Signal mag phone 
35, 		//  8                         // measure_vol_min(analog_ggs,       40286,286,35); уровень сигнала на выходе "Test GGS ** Signal GGS    
35, 		//  9                         // measure_vol_min(analog_gg_radio1, 40287,287,35); уровень сигнала на выходе "Test GGS ** Signal GG Radio1   
35, 		//  10                        // measure_vol_min(analog_gg_radio2, 40288,288,35); уровень сигнала на выходе "Test GGS ** Signal GG Radio2
			   //++++++++++++++++++++++++++++++++++ Сигнал подан на вход GGS ++++++++++++++++++++++++
40,	    	// 11    					  //measure_vol_max(analog_FrontL,    40290,290,40); уровень сигнала на выходе "Test GGS ** Signal FrontL                                   ON  - ";
40,	    	// 12  						  //measure_vol_max(analog_FrontR,    40291,291,40); уровень сигнала на выходе "Test GGS ** Signal FrontR                                   ON  - ";
35,			// 13						  //measure_vol_min(analog_LineL,     40282,282,35); уровень сигнала на выходе "Test GGS ** Signal LineL                                    OFF - ";
35,			// 14						  //measure_vol_min(analog_LineR,     40283,283,35); уровень сигнала на выходе "Test GGS ** Signal LineR                                    OFF - ";
50,	    	// 15						  //measure_vol_max(analog_mag_phone, 40292,292,50); уровень сигнала на выходе "Test GGS ** Signal mag phone                                ON  - ";
160,		// 16			     		  //measure_vol_max(analog_ggs,       40286,289,160); уровень сигнала на выходе "Test GGS ** Signal GGS                                      OFF - ";
35,			// 17						  //measure_vol_min(analog_gg_radio1, 40287,287,35); уровень сигнала на выходе "Test GGS ** Signal GG Radio1                                OFF - ";
35,			// 18						  //measure_vol_min(analog_gg_radio2, 40288,288,35); уровень сигнала на выходе "Test GGS ** Signal GG Radio2                                OFF - ";

40,			// 19						  //measure_vol_max(analog_FrontL,    40290,290,40); уровень сигнала на выходе "Test GGS ** Signal FrontL                                   ON  - ";
40,			// 20 						  //measure_vol_max(analog_FrontR,    40291,291,40); уровень сигнала на выходе "Test GGS ** Signal FrontR                                   ON  - ";
35,			// 21					      //measure_vol_min(analog_LineL,     40282,282,35); уровень сигнала на выходе "Test GGS ** Signal LineL                                    OFF - ";
35,			// 22						  //measure_vol_min(analog_LineR,     40283,283,35); уровень сигнала на выходе "Test GGS ** Signal LineR                                    OFF - ";
35,			// 23						  //measure_vol_min(analog_mag_radio, 40284,284,35); уровень сигнала на выходе "Test GGS ** Signal mag radio                                OFF - ";
50,			// 24						  //measure_vol_max(analog_mag_phone, 40292,292,50); уровень сигнала на выходе "Test GGS ** Signal mag phone                                ON  - ";
35,			// 25						  //measure_vol_min(analog_ggs,       40286,286,35); уровень сигнала на выходе "Test GGS ** Signal GGS                                      OFF - ";
35,			// 26						  //measure_vol_min(analog_gg_radio1, 40287,287,35); уровень сигнала на выходе "Test GGS ** Signal GG Radio1                                OFF - ";
35			// 27						  //measure_vol_min(analog_gg_radio2, 40288,288,35); уровень сигнала на выходе "Test GGS ** Signal GG Radio2                                OFF - ";
};

const byte  porog_Radio1[]    PROGMEM = {
// ++++++++++++++++++++++++++++++++++++++ Test Radio1 +++++++++++++++++++++++++++++++++++++++++++++++++++++

200,		// 0							//resistor(1, 250);  Установить уровень сигнала xx мв
200,		// 1							//resistor(2, 250);  Установить уровень сигнала xx мв
				 //+++++++++++++++++++++++++++++++++++   Проверка отсутствия сигнала на выходах +++++++++++++++++++++++++++++++++++++++++++++++++++++++
35,			// 2							//measure_vol_min(analog_FrontL,    40300,300,35); уровень сигнала на выходе "Test Radio1 ** Signal FrontL                                OFF - ";
35,			// 3							//measure_vol_min(analog_FrontR,    40301,301,35); уровень сигнала на выходе "Test Radio1 ** Signal FrontR                                OFF - ";
35,			// 4							//measure_vol_min(analog_LineL,     40302,302,35); уровень сигнала на выходе "Test Radio1 ** Signal LineL                                 OFF - ";
35,			// 5							//measure_vol_min(analog_LineR,     40303,303,35); уровень сигнала на выходе "Test Radio1 ** Signal LineR                                 OFF - ";
35,			// 6							//measure_vol_min(analog_mag_radio, 40304,304,35); уровень сигнала на выходе "Test Radio1 ** Signal mag radio                             OFF - ";
35,			// 7							//measure_vol_min(analog_mag_phone, 40305,305,35); уровень сигнала на выходе "Test Radio1 ** Signal mag phone                             OFF - ";
35,			// 8							//measure_vol_min(analog_ggs,       40306,306,35); уровень сигнала на выходе "Test Radio1 ** Signal GGS                                   OFF - ";
35,			// 9							//measure_vol_min(analog_gg_radio1, 40307,307,35); уровень сигнала на выходе "Test Radio1 ** Signal GG Radio1                             OFF - ";
35,			// 10							//measure_vol_min(analog_gg_radio2, 40308,308,35); Измерить уровень сигнала на выходе "Test Radio1 ** Signal GG Radio2                             OFF - ";
				  //++++++++++++++++++++++++++++++++++ Сигнал подан на вход  Radio1 ++++++++++++++++++++++++
35,			// 11							//measure_vol_min(analog_FrontL,    40300,300,35); уровень сигнала на выходе "Test Radio1 ** Signal FrontL                                OFF - ";
35,			// 12							//measure_vol_min(analog_FrontR,    40301,301,35); уровень сигнала на выходе "Test Radio1 ** Signal FrontR                                OFF - ";
35,			// 13							//measure_vol_min(analog_LineL,     40302,302,35); уровень сигнала на выходе "Test Radio1 ** Signal LineL                                 OFF - ";
35,			// 14							//measure_vol_min(analog_LineR,     40303,303,35); уровень сигнала на выходе "Test Radio1 ** Signal LineR                                 OFF - ";
35,			// 15							//measure_vol_min(analog_mag_radio, 40304,304,35); уровень сигнала на выходе "Test Radio1 ** Signal mag radio                             OFF - ";
35,			// 16							//measure_vol_min(analog_mag_phone, 40305,305,35); уровень сигнала на выходе "Test Radio1 ** Signal mag phone                             OFF - ";
35,			// 17							//measure_vol_min(analog_ggs,       40306,306,35); уровень сигнала на выходе "Test Radio1 ** Signal GGS                                   OFF - ";
250,		// 18							//measure_vol_max(analog_gg_radio1, 40309,309,250);уровень сигнала на выходе "Test Radio1 ** Signal Radio1                                ON  - ";
35			// 19							//measure_vol_min(analog_gg_radio2, 40308,308,35); уровень сигнала на выходе "Test Radio1 ** Signal GG Radio2       
};

const byte  porog_Radio2[]    PROGMEM = {
// ++++++++++++++++++++++++++++++++++++++ Test Radio2 +++++++++++++++++++++++++++++++++++++++++++++++++++++

200,		// 0							//resistor(1, 250);  Установить уровень сигнала xx мв
200,		// 1							//resistor(2, 250);  Установить уровень сигнала xx мв
				 //+++++++++++++++++++++++++++++++++++   Проверка отсутствия сигнала на выходах +++++++++++++++++++++++++++++++++++++++++++++++++++++++
35,			// 2							//measure_vol_min(analog_FrontL,    40310,310,35); уровень сигнала на выходе "Test Radio2 ** Signal FrontL                                OFF - ";
35,			// 3							//measure_vol_min(analog_FrontR,    40311,311,35); уровень сигнала на выходе "Test Radio2 ** Signal FrontR                                OFF - ";
35,			// 4							//measure_vol_min(analog_LineL,     40312,312,35); уровень сигнала на выходе "Test Radio2 ** Signal LineL                                 OFF - ";
35,			// 5							//measure_vol_min(analog_LineR,     40313,313,35); уровень сигнала на выходе "Test Radio2 ** Signal LineR                                 OFF - ";
35,			// 6 							//measure_vol_min(analog_mag_radio, 40314,314,35); уровень сигнала на выходе "Test Radio2 ** Signal mag radio                             OFF - ";
35,			// 7							//measure_vol_min(analog_mag_phone, 40315,315,35); уровень сигнала на выходе "Test Radio2 ** Signal mag phone                             OFF - ";
35,			// 8							//measure_vol_min(analog_ggs,       40316,316,35); уровень сигнала на выходе "Test Radio2 ** Signal GGS                                   OFF - ";
35,			// 9							//measure_vol_min(analog_gg_radio1, 40317,317,35); уровень сигнала на выходе "Test Radio2 ** Signal GG Radio1                             OFF - ";
35,			// 10							//measure_vol_min(analog_gg_radio2, 40318,318,35); уровень сигнала на выходе "Test Radio2 ** Signal GG Radio2                             OFF - ";
					//++++++++++++++++++++++++++++++++++ Сигнал подан на вход  Radio2 ++++++++++++++++++++++++
35,			// 11							//measure_vol_min(analog_FrontL,    40310,310,35); уровень сигнала на выходе "Test Radio2 ** Signal FrontL                                OFF - ";
35,			// 12							//measure_vol_min(analog_FrontR,    40311,311,35); уровень сигнала на выходе "Test Radio2 ** Signal FrontR                                OFF - ";
35,			// 13							//measure_vol_min(analog_LineL,     40312,312,35); уровень сигнала на выходе "Test Radio2 ** Signal LineL                                 OFF - ";
35,			// 14							//measure_vol_min(analog_LineR,     40313,313,35); уровень сигнала на выходе "Test Radio2 ** Signal LineR                                 OFF - ";
35,			// 15							//measure_vol_min(analog_mag_radio, 40314,314,35); уровень сигнала на выходе "Test Radio2 ** Signal mag radio                             OFF - ";
35,			// 16							//measure_vol_min(analog_mag_phone, 40315,315,35); уровень сигнала на выходе "Test Radio2 ** Signal mag phone                             OFF - ";
35,			// 17							//measure_vol_min(analog_ggs,       40316,316,35); уровень сигнала на выходе "Test Radio2 ** Signal GGS                                   OFF - ";
35,			// 18							//measure_vol_min(analog_gg_radio1, 40317,317,35); уровень сигнала на выходе "Test Radio2 ** Signal Radio1                                ON  - ";
250			// 19							//measure_vol_max(analog_gg_radio2, 40319,319,250);уровень сигнала на выходе "Test Radio2 ** Signal GG Radio2        
};





//---------------------------Тексты сообщений   ---------------------------------------------------
const char  txt_message0[]    PROGMEM            = "  Error! - ";                           
const char  txt_message1[]    PROGMEM            = "Pass";      
const char  txt_message2[]    PROGMEM            = " ****** Test sensor OFF start! ******";    
const char  txt_message3[]    PROGMEM            = " ****** Test sensor ON  start! ******";      
const char  txt_message4[]    PROGMEM            = "Signal headset instructor microphone 30mv     ON"            ;   
const char  txt_message5[]    PROGMEM            = "Microphone headset instructor signal          ON"            ;  
const char  txt_message6[]    PROGMEM            = "Command sensor OFF headset instructor 2             send!"   ;    
const char  txt_message7[]    PROGMEM            = "Command sensor OFF headset instructor               send!"   ;    
const char  txt_message8[]    PROGMEM            = "Command PTT    OFF headset instructor               send!"   ;    
const char  txt_message9[]    PROGMEM            = "Command sensor OFF microphone                       send!"   ;    

const char  txt_message10[]   PROGMEM            = "Command sensor ON  headset instructor 2             send!"   ;     
const char  txt_message11[]   PROGMEM            = "Command sensor ON  headset instructor               send!"   ;     
const char  txt_message12[]   PROGMEM            = "Command        ON  PTT headset instructor (CTS)     send!"   ;  
const char  txt_message13[]   PROGMEM            = "Signal headset dispatcher microphone 30 mV    ON"            ;   
const char  txt_message14[]   PROGMEM            = "Microphone headset dispatcher signal          ON"            ;     
const char  txt_message15[]   PROGMEM            = "Command sensor OFF headset dispatcher 2             send!"   ;    
const char  txt_message16[]   PROGMEM            = "Command sensor OFF headset dispatcher               send!"   ;   
const char  txt_message17[]   PROGMEM            = "Command PTT    OFF headset dispatcher               send!"   ;    
const char  txt_message18[]   PROGMEM            = "Command sensor OFF microphone                       send!"   ;   
const char  txt_message19[]   PROGMEM            = "Command sensor ON  headset dispatcher 2             send!"   ;   

const char  txt_message20[]   PROGMEM            = "Command sensor ON  headset dispatcher               send!"   ;    
const char  txt_message21[]   PROGMEM            = "Command        ON  PTT headset dispatcher (CTS)     send!"   ;  
const char  txt_message22[]   PROGMEM            = " ****** Test headset instructor start! ******"               ; 
const char  txt_message23[]   PROGMEM            = " ****** Test headset dispatcher start! ******"               ;
const char  txt_message24[]   PROGMEM            = " ****** Test MTT start! ******"                              ;  
const char  txt_message25[]   PROGMEM            = " ****** Test tangenta nognaja start! ********"               ;  
const char  txt_message26[]   PROGMEM            = " ****** Test tangenta ruchnaja start! ********"              ; 
const char  txt_message27[]   PROGMEM            = "Command sensor OFF MTT                              send! "  ;
const char  txt_message28[]   PROGMEM            = "Command PTT    OFF MTT                              send! "  ;
const char  txt_message29[]   PROGMEM            = "Command HangUp OFF MTT                              send! "  ;

const char  txt_message30[]   PROGMEM            = "Command sensor ON  MTT                              send!"   ;
const char  txt_message31[]   PROGMEM            = "Command PTT    ON  MTT                              send!"   ;
const char  txt_message32[]   PROGMEM            = "Command HangUp ON  MTT                              send!"   ;
const char  txt_message33[]   PROGMEM            = "Signal MTT microphone 30 mV                   ON"            ;
const char  txt_message34[]   PROGMEM            = "Microphone MTT signal                         ON"            ;  
const char  txt_message35[]   PROGMEM            = "Signal FrontL, FrontR                         ON "           ;
const char  txt_message36[]   PROGMEM            = " ****** Test tangenta ruchnaja start! ******"                ;
const char  txt_message37[]   PROGMEM            = "Command sensor OFF tangenta ruchnaja                send!"   ;
const char  txt_message38[]   PROGMEM            = "Command PTT1   OFF tangenta ruchnaja                send!"   ;
const char  txt_message39[]   PROGMEM            = "Command PTT2   OFF tangenta ruchnaja                send!"   ; 

const char  txt_message40[]   PROGMEM            = "Command sensor ON  tangenta ruchnaja                send!"   ;
const char  txt_message41[]   PROGMEM            = "Command PTT1   ON  tangenta ruchnaja                send!"   ;
const char  txt_message42[]   PROGMEM            = "Command PTT2   ON  tangenta ruchnaja                send!"   ;
const char  txt_message43[]   PROGMEM            = " ****** Test tangenta nognaja start! ******"                 ;
const char  txt_message44[]   PROGMEM            = "Command sensor OFF tangenta nognaja                 send!"   ;
const char  txt_message45[]   PROGMEM            = "Command PTT    OFF tangenta nognaja                 send!"   ;
const char  txt_message46[]   PROGMEM            = "Command sensor ON  tangenta nognaja                 send!"   ;
const char  txt_message47[]   PROGMEM            = "Command PTT    ON  tangenta nognaja                 send!"   ;
const char  txt_message48[]   PROGMEM            = " ****** Test GGS start! ******"      ;
const char  txt_message49[]   PROGMEM            = "Signal GGS  FrontL, FrontR   0,7V             ON"            ;

const char  txt_message50[]   PROGMEM            = " ****** Test Radio1 start! ******"                           ;
const char  txt_message51[]   PROGMEM            = "Signal Radio1 300 mV    LFE                   ON"            ;
const char  txt_message52[]   PROGMEM            = " ****** Test Radio2 start! ******"      ;
const char  txt_message53[]   PROGMEM            = "Signal Radio1 300 mV    Center                ON"            ;
const char  txt_message54[]   PROGMEM            = " ****** Test microphone start! ******"                       ;
const char  txt_message55[]   PROGMEM            = "Signal miсrophone 30  mV                      ON"            ;
const char  txt_message56[]   PROGMEM            = "Command PTT    OFF microphone                       send!"   ;
const char  txt_message57[]   PROGMEM            = "Command PTT    ON  microphone                       send!"   ;
const char  txt_message58[]   PROGMEM            = "Command sensor OFF microphone                       send!"   ;  
const char  txt_message59[]   PROGMEM            = "Command sensor ON  microphone                       send!"   ;

const char  txt_message60[]   PROGMEM            = "Power amperage                              mA - "   ;
const char  txt_message61[]   PROGMEM            = "Power module Audio 2                           - "   ;
const char  txt_message62[]   PROGMEM            = "Power amperage                              mA - "   ;
const char  txt_message63[]   PROGMEM            = "Power Radio1                                   - "   ;
const char  txt_message64[]   PROGMEM            = "Power Radio2                                   - "   ;
const char  txt_message65[]   PROGMEM            = "Power GGS                                      - "   ;
const char  txt_message66[]   PROGMEM            = "Power Led microphone                           -  "  ;
const char  txt_message67[]   PROGMEM            = " ****** Test power start! ******"                            ;
const char  txt_message68[]   PROGMEM            = " ****** Test Adjusting the brightness of the display! ******"; 
const char  txt_message69[]   PROGMEM            = "Adjusting the brightness code                              - "   ;
const char  txt_message70[]   PROGMEM            = "Adjusting the brightness mks                               - "   ;




//++++++++++++++++++++++++++++++ Тексты ошибок ++++++++++++++++++++++++++++++++++++++++++++++++++++++++++++++++++++++
const char  txt_error0[]  PROGMEM              = "Sensor MTT                          XP1- 19 HaSs    OFF - ";
const char  txt_error1[]  PROGMEM              = "Sensor tangenta ruchnaja            XP7 - 2         OFF - ";
const char  txt_error2[]  PROGMEM              = "Sensor tangenta nognaja             XP8 - 2         OFF - "; 
const char  txt_error3[]  PROGMEM              = "Sensor headset instructor 2         XP1- 16 HeS2Rs  OFF - ";
const char  txt_error4[]  PROGMEM              = "Sensor headset instructor           XP1- 13 HeS2Ls  OFF - "; 
const char  txt_error5[]  PROGMEM              = "Sensor headset dispatcher 2         XP1- 5  HeS1Rs  OFF - "; 
const char  txt_error6[]  PROGMEM              = "Sensor headset dispatcher           XP1- 1  HeS1Ls  OFF - ";
const char  txt_error7[]  PROGMEM              = "Sensor microphone                   XS1 - 6         OFF - "; 
const char  txt_error8[]  PROGMEM              = "Microphone headset instructor Sw.   XP1 12 HeS2e    OFF - "; 
const char  txt_error9[]  PROGMEM              = "Microphone headset dispatcher Sw.   XP1 12 HeS2e    OFF - ";  

const char  txt_error10[]  PROGMEM             = "Sensor MTT                          XP1- 19 HaSs    ON  - "; 
const char  txt_error11[]  PROGMEM             = "Sensor tangenta ruchnaja            XP7 - 2         ON  - ";
const char  txt_error12[]  PROGMEM             = "Sensor tangenta nognaja             XP8 - 2         ON  - "; 
const char  txt_error13[]  PROGMEM             = "Sensor headset instructor 2         XP1- 16 HeS2Rs  ON  - ";
const char  txt_error14[]  PROGMEM             = "Sensor headset instructor           XP1- 13 HeS2Ls  ON  - "; 
const char  txt_error15[]  PROGMEM             = "Sensor headset dispatcher 2         XP1- 5  HeS1Rs  ON  - "; 
const char  txt_error16[]  PROGMEM             = "Sensor headset dispatcher           XP1- 1  HeS1Ls  ON  - ";
const char  txt_error17[]  PROGMEM             = "Sensor microphone                   XS1 - 6         ON  - "; 
const char  txt_error18[]  PROGMEM             = "Microphone headset instructor Sw.   XP1 12 HeS2e    ON  - "; 
const char  txt_error19[]  PROGMEM             = "Microphone headset dispatcher Sw.   XP1 10 HeS1e    ON  - "; 
  
const char  txt_error20[]  PROGMEM             = "Command PTT headset instructor (CTS)                OFF - ";
const char  txt_error21[]  PROGMEM             = "Command PTT headset instructor (CTS)                ON  - ";
const char  txt_error22[]  PROGMEM             = "Command PTT headset dispatcher (CTS)                OFF - ";
const char  txt_error23[]  PROGMEM             = "Command PTT headset dispatcher (CTS)                ON  - ";
const char  txt_error24[]  PROGMEM             = "Test headset instructor ** Signal LineL             ON  - ";
const char  txt_error25[]  PROGMEM             = "Test headset instructor ** Signal LineR             ON  - ";   
const char  txt_error26[]  PROGMEM             = "Test headset instructor ** Signal Mag phone         ON  - ";
const char  txt_error27[]  PROGMEM             = "Test headset dispatcher ** Signal LineL             ON  - ";
const char  txt_error28[]  PROGMEM             = "Test headset dispatcher ** Signal LineR             ON  - ";  
const char  txt_error29[]  PROGMEM             = "Test headset dispatcher ** Signal Mag phone         ON  - ";

const char  txt_error30[]  PROGMEM             = "Test headset instructor ** Signal FrontL            OFF - ";
const char  txt_error31[]  PROGMEM             = "Test headset instructor ** Signal FrontR            OFF - ";
const char  txt_error32[]  PROGMEM             = "Test headset instructor ** Signal LineL             OFF - ";
const char  txt_error33[]  PROGMEM             = "Test headset instructor ** Signal LineR             OFF - ";
const char  txt_error34[]  PROGMEM             = "Test headset instructor ** Signal mag radio         OFF - ";
const char  txt_error35[]  PROGMEM             = "Test headset instructor ** Signal mag phone         OFF - ";
const char  txt_error36[]  PROGMEM             = "Test headset instructor ** Signal GGS               OFF - ";
const char  txt_error37[]  PROGMEM             = "Test headset instructor ** Signal GG Radio1         OFF - ";
const char  txt_error38[]  PROGMEM             = "Test headset instructor ** Signal GG Radio2         OFF - ";
const char  txt_error39[]  PROGMEM             = "";

const char  txt_error40[]  PROGMEM             = "Test headset dispatcher ** Signal FrontL            OFF - ";
const char  txt_error41[]  PROGMEM             = "Test headset dispatcher ** Signal FrontR            OFF - ";
const char  txt_error42[]  PROGMEM             = "Test headset dispatcher ** Signal LineL             OFF - ";
const char  txt_error43[]  PROGMEM             = "Test headset dispatcher ** Signal LineR             OFF - ";
const char  txt_error44[]  PROGMEM             = "Test headset dispatcher ** Signal mag radio         OFF - ";
const char  txt_error45[]  PROGMEM             = "Test headset dispatcher ** Signal mag phone         OFF - ";
const char  txt_error46[]  PROGMEM             = "Test headset dispatcher ** Signal GGS               OFF - ";
const char  txt_error47[]  PROGMEM             = "Test headset dispatcher ** Signal GG Radio1         OFF - ";
const char  txt_error48[]  PROGMEM             = "Test headset dispatcher ** Signal GG Radio2         OFF - ";
const char  txt_error49[]  PROGMEM             = "";

const char  txt_error50[]  PROGMEM             = "Test MTT ** Signal FrontL                           OFF - ";
const char  txt_error51[]  PROGMEM             = "Test MTT ** Signal FrontR                           OFF - ";
const char  txt_error52[]  PROGMEM             = "Test MTT ** Signal LineL                            OFF - ";
const char  txt_error53[]  PROGMEM             = "Test MTT ** Signal LineR                            OFF - ";
const char  txt_error54[]  PROGMEM             = "Test MTT ** Signal mag radio                        OFF - ";
const char  txt_error55[]  PROGMEM             = "Test MTT ** Signal mag phone                        OFF - ";
const char  txt_error56[]  PROGMEM             = "Test MTT ** Signal GGS                              OFF - ";
const char  txt_error57[]  PROGMEM             = "Test MTT ** Signal GG Radio1                        OFF - ";
const char  txt_error58[]  PROGMEM             = "Test MTT ** Signal GG Radio2                        OFF - ";
const char  txt_error59[]  PROGMEM             = "Test MTT ** Signal GGS                              ON  - ";

const char  txt_error60[]  PROGMEM             = "Test MTT ** Signal LineL                            ON  - ";
const char  txt_error61[]  PROGMEM             = "Test MTT ** Signal LineR                            ON  - ";  
const char  txt_error62[]  PROGMEM             = "Test MTT ** Signal Mag phone                        ON  - ";
const char  txt_error63[]  PROGMEM             = "Test MTT PTT    (CTS)                               OFF - ";
const char  txt_error64[]  PROGMEM             = "Test microphone PTT  (CTS)                          OFF - ";
const char  txt_error65[]  PROGMEM             = "Test MTT PTT    (CTS)                               ON  - ";
const char  txt_error66[]  PROGMEM             = "Test microphone PTT  (CTS)                          ON  - ";
const char  txt_error67[]  PROGMEM             = "Test MTT HangUp (DCD)                               OFF - ";
const char  txt_error68[]  PROGMEM             = "Test MTT HangUp (DCD)                               ON  - ";
const char  txt_error69[]  PROGMEM             = "";

const char  txt_error70[]  PROGMEM             = "Command PTT1 tangenta ruchnaja (CTS)                OFF - ";
const char  txt_error71[]  PROGMEM             = "Command PTT2 tangenta ruchnaja (DCR)                OFF - ";
const char  txt_error72[]  PROGMEM             = "Command PTT1 tangenta ruchnaja (CTS)                ON  - ";
const char  txt_error73[]  PROGMEM             = "Command PTT2 tangenta ruchnaja (DCR)                ON  - ";
const char  txt_error74[]  PROGMEM             = "Command sensor tangenta ruchnaja    XP7 - 2         OFF - ";
const char  txt_error75[]  PROGMEM             = "Command sensor tangenta ruchnaja    XP7 - 2         ON  - ";
const char  txt_error76[]  PROGMEM             = "Command sensor tangenta nognaja     XP8 - 2         OFF - ";
const char  txt_error77[]  PROGMEM             = "Command sensor tangenta nognaja     XP8 - 2         ON  - ";
const char  txt_error78[]  PROGMEM             = "Command PTT tangenta nognaja (CTS)  XP8 - 1         OFF - ";
const char  txt_error79[]  PROGMEM             = "Command PTT tangenta nognaja (CTS)  XP8 - 1         ON  - ";

const char  txt_error80[]  PROGMEM             = "Test GGS ** Signal FrontL                           OFF - ";
const char  txt_error81[]  PROGMEM             = "Test GGS ** Signal FrontR                           OFF - ";
const char  txt_error82[]  PROGMEM             = "Test GGS ** Signal LineL                            OFF - ";
const char  txt_error83[]  PROGMEM             = "Test GGS ** Signal LineR                            OFF - ";
const char  txt_error84[]  PROGMEM             = "Test GGS ** Signal mag radio                        OFF - ";
const char  txt_error85[]  PROGMEM             = "Test GGS ** Signal mag phone                        OFF - ";
const char  txt_error86[]  PROGMEM             = "Test GGS ** Signal GGS                              OFF - ";
const char  txt_error87[]  PROGMEM             = "Test GGS ** Signal GG Radio1                        OFF - ";
const char  txt_error88[]  PROGMEM             = "Test GGS ** Signal GG Radio2                        OFF - ";
const char  txt_error89[]  PROGMEM             = "Test GGS ** Signal GGS                              ON  - ";

const char  txt_error90[]  PROGMEM             = "Test GGS ** Signal FrontL                           ON  - ";
const char  txt_error91[]  PROGMEM             = "Test GGS ** Signal FrontR                           ON  - ";
const char  txt_error92[]  PROGMEM             = "Test GGS ** Signal mag phone                        ON  - ";
const char  txt_error93[]  PROGMEM             = "";  
const char  txt_error94[]  PROGMEM             = "";
const char  txt_error95[]  PROGMEM             = ""; 
const char  txt_error96[]  PROGMEM             = "";    
const char  txt_error97[]  PROGMEM             = "";  
const char  txt_error98[]  PROGMEM             = "Test Microphone ** Signal mag phone                 ON  - ";  
const char  txt_error99[]  PROGMEM             = "Test Microphone ** Signal LineL                     ON  - "; 

const char  txt_error100[]  PROGMEM            = "Test Radio1 ** Signal FrontL                        OFF - ";
const char  txt_error101[]  PROGMEM            = "Test Radio1 ** Signal FrontR                        OFF - ";
const char  txt_error102[]  PROGMEM            = "Test Radio1 ** Signal LineL                         OFF - ";
const char  txt_error103[]  PROGMEM            = "Test Radio1 ** Signal LineR                         OFF - ";
const char  txt_error104[]  PROGMEM            = "Test Radio1 ** Signal mag radio                     OFF - ";
const char  txt_error105[]  PROGMEM            = "Test Radio1 ** Signal mag phone                     OFF - ";
const char  txt_error106[]  PROGMEM            = "Test Radio1 ** Signal GGS                           OFF - ";
const char  txt_error107[]  PROGMEM            = "Test Radio1 ** Signal GG Radio1                     OFF - ";
const char  txt_error108[]  PROGMEM            = "Test Radio1 ** Signal GG Radio2                     OFF - ";
const char  txt_error109[]  PROGMEM            = "Test Radio1 ** Signal Radio1                        ON  - ";

const char  txt_error110[]  PROGMEM            = "Test Radio2 ** Signal FrontL                        OFF - ";
const char  txt_error111[]  PROGMEM            = "Test Radio2 ** Signal FrontR                        OFF - ";
const char  txt_error112[]  PROGMEM            = "Test Radio2 ** Signal LineL                         OFF - ";
const char  txt_error113[]  PROGMEM            = "Test Radio2 ** Signal LineR                         OFF - ";
const char  txt_error114[]  PROGMEM            = "Test Radio2 ** Signal mag radio                     OFF - ";
const char  txt_error115[]  PROGMEM            = "Test Radio2 ** Signal mag phone                     OFF - ";
const char  txt_error116[]  PROGMEM            = "Test Radio2 ** Signal GGS                           OFF - ";
const char  txt_error117[]  PROGMEM            = "Test Radio2 ** Signal GG Radio1                     OFF - ";
const char  txt_error118[]  PROGMEM            = "Test Radio2 ** Signal GG Radio2                     OFF - ";
const char  txt_error119[]  PROGMEM            = "Test Radio2 ** Signal Radio2                        ON  - ";

const char  txt_error120[]  PROGMEM            = "Test Microphone ** Signal FrontL                    OFF - ";
const char  txt_error121[]  PROGMEM            = "Test Microphone ** Signal FrontR                    OFF - ";
const char  txt_error122[]  PROGMEM            = "Test Microphone ** Signal LineL                     OFF - ";
const char  txt_error123[]  PROGMEM            = "Test Microphone ** Signal LineR                     OFF - ";
const char  txt_error124[]  PROGMEM            = "Test Microphone ** Signal mag radio                 OFF - ";
const char  txt_error125[]  PROGMEM            = "Test Microphone ** Signal mag phone                 OFF - ";
const char  txt_error126[]  PROGMEM            = "Test Microphone ** Signal GGS                       OFF - ";
const char  txt_error127[]  PROGMEM            = "Test Microphone ** Signal GG Radio1                 OFF - ";
const char  txt_error128[]  PROGMEM            = "Test Microphone ** Signal GG Radio2                 OFF - ";
const char  txt_error129[]  PROGMEM            = "";

char buffer[130];  

const char* const table_message[] PROGMEM = 
{
txt_message0,                                 // "    Error! - ";                           
txt_message1,                                 // "Pass";      
txt_message2,                                 // " ****** Test sensor OFF start! ******";    
txt_message3,                                 // " ****** Test sensor ON  start! ******";      
txt_message4,                                 // "Signal headset instructor microphone 30mv     ON"            ;   
txt_message5,                                 // "Microphone headset instructor signal          ON"            ;  
txt_message6,                                 // "Command sensor OFF headset instructor 2          send!"      ; 
txt_message7,                                 // "Command sensor OFF headset instructor            send!"      ;  
txt_message8,                                 // "Command PTT    OFF headset instructor            send!"      ;    
txt_message9,                                 // "Command sensor OFF microphone                    send!"      ;  
txt_message10,                                // "Command sensor ON  headset instructor 2          send!"      ;    
txt_message11,                                // "Command sensor ON  headset instructor            send!"      ;   
txt_message12,                                // "Command        ON  PTT headset instructor (CTS)  send!"      ;  
txt_message13,                                // "Signal headset dispatcher microphone 30mv     ON"            ;   
txt_message14,                                // "Microphone headset dispatcher signal          ON"            ;     
txt_message15,                                // "Command sensor OFF headset dispatcher 2          send!"      ;  
txt_message16,                                // "Command sensor OFF headset dispatcher            send!"      ;  
txt_message17,                                // "Command PTT    OFF headset dispatcher            send!"      ;    
txt_message18,                                // "Command sensor OFF microphone                    send!"      ;   
txt_message19,                                // "Command sensor ON  headset dispatcher 2          send!"      ;  
txt_message20,                                // "Command sensor ON  headset dispatcher            send!"      ;   
txt_message21,                                // "Command        ON  PTT headset dispatcher (CTS)  send!"      ;  
txt_message22,                                // " ****** Test headset instructor start! ******"               ; 
txt_message23,                                // " ****** Test headset dispatcher start! ******"               ;
txt_message24,                                // " ****** Test MTT start! ******"                              ;  
txt_message25,                                // " ****** Test tangenta nognaja start! ********"               ;  
txt_message26,                                // " ****** Test tangenta ruchnaja start! ********"              ; 
txt_message27,                                // "Command sensor OFF MTT                           send! "     ;
txt_message28,                                // "Command PTT    OFF MTT                           send! "     ;
txt_message29,                                // "Command HangUp OFF MTT                           send! "     ;
txt_message30,                                // "Command sensor ON  MTT                           send!"      ;
txt_message31,                                // "Command PTT    ON  MTT                           send!"      ;
txt_message32,                                // "Command HangUp ON  MTT                           send!"      ;
txt_message33,                                // "Signal MTT microphone 30mv                    ON"            ;
txt_message34,                                // "Microphone MTT signal                         ON"            ;  
txt_message35,                                // "Signal FrontL, FrontR                         ON "           ;
txt_message36,                                // " ****** Test tangenta ruchnaja start! ******"                ;
txt_message37,                                // "Command sensor OFF tangenta ruchnaja             send!"      ;
txt_message38,                                // "Command PTT1   OFF tangenta ruchnaja             send!"      ;
txt_message39,                                // "Command PTT2   OFF tangenta ruchnaja             send!"      ; 
txt_message40,                                // "Command sensor ON  tangenta ruchnaja             send!"      ;
txt_message41,                                // "Command PTT1   ON  tangenta ruchnaja             send!"      ;
txt_message42,                                // "Command PTT2   ON  tangenta ruchnaja             send!"      ;
txt_message43,                                // " ****** Test tangenta nognaja start! ******"                 ;
txt_message44,                                // "Command sensor OFF tangenta nognaja              send!"      ;
txt_message45,                                // "Command PTT    OFF tangenta nognaja              send!"      ;
txt_message46,                                // "Command sensor ON  tangenta nognaja              send!"      ;
txt_message47,                                // "Command PTT    ON  tangenta nognaja              send!"      ;
txt_message48,                                // " ****** Test GGS start! ******"      ;
txt_message49,                                // "Signal GGS  FrontL, FrontR   0,7v             ON"            ;

txt_message50,                                // " ****** Test Radio1 start! ******"      ;
txt_message51,                                // "Signal Radio1 200 mV    LFE                   ON"            ;
txt_message52,                                //" ****** Test Radio2 start! ******"      ;
txt_message53,                                // "Signal Radio1 300 mV    Center                ON"            ;
txt_message54,                                // " ****** Test miсrophone start! ******"                       ;
txt_message55,                                // "Signal miсrophone 30  mV                      ON"            ;
txt_message56,                                // "Command PTT    OFF microphone                    send!"      ;
txt_message57,                                // "Command PTT    ON  microphone                    send!"      ;
txt_message58,                                // "Command sensor OFF microphone                    send!"      ;  
txt_message59,                                // "Command sensor ON  microphone                    send!"      ;

txt_message60,                                // "Power amperage mA - "                                        ;
txt_message61,                                // "Power Kamerton V  - "                                        ;
txt_message62,                                // "Power amperage mA - "                                        ;
txt_message63,                                // "Power Radio1 V    - "                                        ;
txt_message64,                                // "Power Radio2 V    - "                                        ;
txt_message65,                                // "Power GGS    V    - "                                        ;
txt_message66,                                // "Power Led mic.V   - "                                        ;
txt_message67,                                // " ****** Test power start! ******"                            ;
txt_message68,                                // " ****** Test Adjusting the brightness of the display! ******"; 
txt_message69,                                // "Adjusting the brightness code                              - "   ;
txt_message70                                 // "Adjusting the brightness mks                               - "   ;
};

const char* const string_table_err[] PROGMEM = 
{
txt_error0,                                   // "Sensor MTT                          XP1- 19 HaSs            OFF - ";
txt_error1,                                   // "Sensor tangenta ruchnaja            XP7 - 2                 OFF - ";
txt_error2,                                   // "Sensor tangenta nognaja             XP8 - 2                 OFF - "; 
txt_error3,                                   // "Sensor headset instructor 2         XP1- 16 HeS2Rs          OFF - ";
txt_error4,                                   // "Sensor headset instructor           XP1- 13 HeS2Ls          OFF - "; 
txt_error5,                                   // "Sensor headset dispatcher 2         XP1- 13 HeS2Ls          OFF - ";
txt_error6,                                   // "Sensor headset dispatcher           XP1- 1  HeS1Ls          OFF - ";
txt_error7,                                   // "Sensor microphone                   XS1 - 6                 OFF - "; 
txt_error8,                                   // "Microphone headset instructor Sw.   XP1 12 HeS2e            OFF - "; 
txt_error9,                                   // "Microphone headset dispatcher Sw.   XP1 12 HeS2e            OFF - "; 

txt_error10,                                  // "Sensor MTT                          XP1- 19 HaSs            ON  - ";
txt_error11,                                  // "Sensor tangenta ruchnaja            XP7 - 2                 ON  - ";
txt_error12,                                  // "Sensor tangenta nognaja             XP8 - 2                 ON  - "; 
txt_error13,                                  // "Sensor headset instructor 2         XP1- 16 HeS2Rs          ON  - ";
txt_error14,                                  // "Sensor headset instructor           XP1- 13 HeS2Ls          ON  - "; 
txt_error15,                                  // "Sensor headset dispatcher 2         XP1- 13 HeS2Ls          ON  - ";
txt_error16,                                  // "Sensor headset dispatcher           XP1- 1  HeS1Ls          ON  - ";
txt_error17,                                  // "Sensor microphone                   XS1 - 6                 ON  - "; 
txt_error18,                                  // "Microphone headset instructor Sw.   XP1 12 HeS2e            ON  - "; 
txt_error19,                                  // "Microphone headset dispatcher Sw.   XP1 10 HeS1e            ON  - "; 

txt_error20,                                  // "Command PTT headset instructor (CTS)                        OFF - ";
txt_error21,                                  // "Command PTT headset instructor (CTS)                        ON  - ";
txt_error22,                                  // "Command PTT headset dispatcher (CTS)                        OFF - ";
txt_error23,                                  // "Command PTT headset dispatcher (CTS)                        ON  - ";
txt_error24,                                  // "Test headset instructor ** Signal LineL                     ON  - ";
txt_error25,                                  // "Test headset instructor ** Signal LineR                     ON  - ";   
txt_error26,                                  // "Test headset instructor ** Signal Mag phone                 ON  - ";
txt_error27,                                  // "Test headset dispatcher ** Signal LineL                     ON  - ";
txt_error28,                                  // "Test headset dispatcher ** Signal LineR                     ON  - ";  
txt_error29,                                  // "Test headset dispatcher ** Signal Mag phone                 ON  - ";

txt_error30,                                  // "Test headset instructor ** Signal FrontL                    OFF - ";
txt_error31,                                  // "Test headset instructor ** Signal FrontR                    OFF - ";
txt_error32,                                  // "Test headset instructor ** Signal LineL                     OFF - ";
txt_error33,                                  // "Test headset instructor ** Signal LineR                     OFF - ";
txt_error34,                                  // "Test headset instructor ** Signal mag radio                 OFF - "; 
txt_error35,                                  // "Test headset instructor ** Signal mag phone                 OFF - ";
txt_error36,                                  // "Test headset instructor ** Signal GGS                       OFF - ";
txt_error37,                                  // "Test headset instructor ** Signal GG Radio1                 OFF - ";
txt_error38,                                  // "Test headset instructor ** Signal GG Radio2                 OFF - ";
txt_error39,                                  //

txt_error40,                                  // "Test headset dispatcher ** Signal FrontL                    OFF - ";
txt_error41,                                  // "Test headset dispatcher ** Signal FrontR                    OFF - ";
txt_error42,                                  // "Test headset dispatcher ** Signal LineL                     OFF - "; 
txt_error43,                                  // "Test headset dispatcher ** Signal LineR                     OFF - ";
txt_error44,                                  // "Test headset dispatcher ** Signal mag radio                 OFF - "; 
txt_error45,                                  // "Test headset dispatcher ** Signal mag phone                 OFF - ";
txt_error46,                                  // "Test headset dispatcher ** Signal GGS                       OFF - "; 
txt_error47,                                  // "Test headset dispatcher ** Signal GG Radio1                 OFF - ";
txt_error48,                                  // "Test headset dispatcher ** Signal GG Radio2                 OFF - "; 
txt_error49,                                  //  

txt_error50,                                  // "Test MTT ** Signal FrontL                                   OFF - ";
txt_error51,                                  // "Test MTT ** Signal FrontR                                   OFF - ";
txt_error52,                                  // "Test MTT ** Signal LineL                                    OFF - ";
txt_error53,                                  // "Test MTT ** Signal LineR                                    OFF - "; 
txt_error54,                                  // "Test MTT ** Signal mag radio                                OFF - ";
txt_error55,                                  // "Test MTT ** Signal mag phone                                OFF - ";
txt_error56,                                  // "Test MTT ** Signal GGS                                      OFF - ";
txt_error57,                                  // "Test MTT ** Signal GG Radio1                                OFF - ";
txt_error58,                                  // "Test MTT ** Signal GG Radio2                                OFF - "; 
txt_error59,                                  // "Test MTT ** Signal GGS                                      ON  - ";

txt_error60,                                  // "Test MTT ** Signal LineL                                    ON  - ";
txt_error61,                                  // "Test MTT ** Signal LineR                                    ON  - ";  
txt_error62,                                  // "Test MTT ** Signal Mag phone                                ON  - ";
txt_error63,                                  // "Test MTT PTT    (CTS)                                       OFF - ";
txt_error64,                                  // "Test microphone PTT  (CTS)                                  OFF - ";
txt_error65,                                  // "Test MTT PTT    (CTS)                                       ON  - ";
txt_error66,                                  // "Test microphone PTT  (CTS)                                  ON  - ";
txt_error67,                                  // "Test MTT HangUp (DCD)                                       OFF - ";
txt_error68,                                  // "Test MTT HangUp (DCD)                                       ON  - ";
txt_error69,                                  //

txt_error70,                                  // "Command PTT1 tangenta ruchnaja (CTS)                        OFF - ";
txt_error71,                                  // "Command PTT2 tangenta ruchnaja (DCR)                        OFF - ";
txt_error72,                                  // "Command PTT1 tangenta ruchnaja (CTS)                        ON  - ";
txt_error73,                                  // "Command PTT2 tangenta ruchnaja (DCR)                        ON  - ";
txt_error74,                                  // "Command sensor tangenta ruchnaja                            OFF - ";
txt_error75,                                  // "Command sensor tangenta ruchnaja                            ON  - ";
txt_error76,                                  // "Command sensor tangenta nognaja     XP8 - 2                 OFF - ";
txt_error77,                                  // "Command sensor tangenta nognaja     XP8 - 2                 ON  - ";
txt_error78,                                  // "Command PTT tangenta nognaja (CTS)  XP8 - 1                 OFF - ";  
txt_error79,                                  // "Command PTT tangenta nognaja (CTS)  XP8 - 1                 ON  - "; 

txt_error80,                                  // "Test GGS ** Signal FrontL                                   OFF - ";
txt_error81,                                  // "Test GGS ** Signal FrontR                                   OFF - ";
txt_error82,                                  // "Test GGS ** Signal LineL                                    OFF - ";
txt_error83,                                  // "Test GGS ** Signal LineR                                    OFF - ";
txt_error84,                                  // "Test GGS ** Signal mag radio                                OFF - ";
txt_error85,                                  // "Test GGS ** Signal mag phone                                OFF - ";
txt_error86,                                  // "Test GGS ** Signal GGS                                      OFF - ";
txt_error87,                                  // "Test GGS ** Signal GG Radio1                                OFF - ";
txt_error88,                                  // "Test GGS ** Signal GG Radio2                                OFF - ";
txt_error89,                                  // "Test GGS ** Signal GGS                                      ON  - ";

txt_error90,                                  // "Test GGS ** Signal FrontL                                   ON  - ";
txt_error91,                                  // "Test GGS ** Signal FrontR                                   ON  - ";
txt_error92,                                  // "Test GGS ** Signal mag phone                                ON  - ";
txt_error93,                                  // 
txt_error94,                                  // 
txt_error95,                                  // 
txt_error96,                                  // 
txt_error97,                                  // 
txt_error98,                                  // "Test Microphone ** Signal mag phone                         ON  - ";   
txt_error99,                                  // "Test Microphone ** Signal LineL                             ON  - "; 

txt_error100,                                 // "Test Radio1 ** Signal FrontL                                OFF - ";
txt_error101,                                 // "Test Radio1 ** Signal FrontR                                OFF - ";
txt_error102,                                 // "Test Radio1 ** Signal LineL                                 OFF - ";
txt_error103,                                 // "Test Radio1 ** Signal LineR                                 OFF - ";
txt_error104,                                 // "Test Radio1 ** Signal mag radio                             OFF - ";
txt_error105,                                 // "Test Radio1 ** Signal mag phone                             OFF - ";
txt_error106,                                 // "Test Radio1 ** Signal GGS                                   OFF - ";
txt_error107,                                 // "Test Radio1 ** Signal GG Radio1                             OFF - ";
txt_error108,                                 // "Test Radio1 ** Signal GG Radio2                             OFF - ";
txt_error109,                                 // "Test Radio1 ** Signal Radio1                                ON  - ";

txt_error110,                                 // "Test Radio2 ** Signal FrontL                                OFF - ";
txt_error111,                                 // "Test Radio2 ** Signal FrontR                                OFF - ";
txt_error112,                                 // "Test Radio2 ** Signal LineL                                 OFF - ";
txt_error113,                                 // "Test Radio2 ** Signal LineR                                 OFF - ";
txt_error114,                                 // "Test Radio2 ** Signal mag radio                             OFF - ";
txt_error115,                                 // "Test Radio2 ** Signal mag phone                             OFF - ";
txt_error116,                                 // "Test Radio2 ** Signal GGS                                   OFF - ";
txt_error117,                                 // "Test Radio2 ** Signal GG Radio1                             OFF - ";
txt_error118,                                 // "Test Radio2 ** Signal GG Radio2                             OFF - ";
txt_error119,                                 // "Test Radio2 ** Signal Radio2                                ON  - ";

txt_error120,                                 // "Test Microphone ** Signal FrontL                            OFF - ";
txt_error121,                                 // "Test Microphone ** Signal FrontR                            OFF - ";
txt_error122,                                 // "Test Microphone ** Signal LineL                             OFF - ";
txt_error123,                                 // "Test Microphone ** Signal LineR                             OFF - ";
txt_error124,                                 // "Test Microphone ** Signal mag radio                         OFF - ";
txt_error125,                                 // "Test Microphone ** Signal mag phone                         OFF - ";
txt_error126,                                 // "Test Microphone ** Signal GGS                               OFF - ";
txt_error127,                                 // "Test Microphone ** Signal GG Radio1                         OFF - ";
txt_error128,                                 // "Test Microphone ** Signal GG Radio2                         OFF - ";
txt_error129,                                 // ";

};

// ========================= Блок программ ============================================

void dateTime(uint16_t* date, uint16_t* time)                  // Программа записи времени и даты файла
{
  DateTime now = RTC.now();

  // return date using FAT_DATE macro to format fields
  *date = FAT_DATE(now.year(), now.month(), now.day());

  // return time using FAT_TIME macro to format fields
  *time = FAT_TIME(now.hour(), now.minute(), now.second());
}

void serial_print_date()                           // Печать даты и времени    
{
	  DateTime now = RTC.now();
	  Serial.print(now.day(), DEC);
	  Serial.print('/');
	  Serial.print(now.month(), DEC);
	  Serial.print('/');
	  Serial.print(now.year(), DEC);//Serial display time
	  Serial.print(' ');
	  Serial.print(now.hour(), DEC);
	  Serial.print(':');
	  Serial.print(now.minute(), DEC);
	  Serial.print(':');
	  Serial.print(now.second(), DEC);
}

const int8_t ERROR_LED_PIN = 13;



void set_time()
{
	RTC.adjust(DateTime(__DATE__, __TIME__));
//	DateTime now = RTC.now();
//	second = now.second();       //Initialization time
//	minute = now.minute();
//	hour   = now.hour();
//	day    =  now.day();
//	day++;
//	if(day > 31)day = 1;
//	month  = now.month();
//	year   = now.year();
//	DateTime set_time = DateTime(year, month, day, hour, minute, second); // Занести данные о времени в строку "set_time"
//	RTC.adjust(set_time);             
}

void flash_time()                                              // Программа обработчик прерывания 
{ 
		prer_Kmerton_Run = true;
	//		digitalWrite(ledPin12,HIGH);
		prer_Kamerton();
		slave.run(); 
		//	digitalWrite(ledPin12,LOW);
		prer_Kmerton_Run = false;
}

void serialEvent3()
{
	//wdt_reset();  // Сброс сторожевого таймера при наличии связи с ПК
	//while (prer_Kmerton_Run){}
	//if (portFound == true)
	//{
	//slave.run(); 
	//}
}
//fileName_F
void serialEvent2()
{
	/*
<<<<<<< .mine
	//if (Serial2.available())                             // есть что-то проверить? Есть данные в буфере?
	//	  {
	//		unsigned char overflowFlag = 0 ;               // Флаг превышения размера буфера
	//		unsigned char buffer = 0;                      // Установить в начало чтения буфера
=======
	if (Serial2.available())                             // есть что-то проверить? Есть данные в буфере?
		  {
			unsigned char overflowFlag = 0 ;               // Флаг превышения размера буфера
			unsigned char buffer_count = 0;                      // Установить в начало чтения буфера
>>>>>>> .r274

<<<<<<< .mine
	//		while (Serial2.available())
	//			{
	//			  if (overflowFlag)                        // Если буфер переполнен - очистить
	//				 Serial2.read();
	//			  else                                     // Размер буфера в норме, считать информацию
	//				{
	//				if (bufferK == BUFFER_SIZEKF)           // Проверить размер буфера
	//					{
	//						overflowFlag = 1;              // Установить флаг превышения размера буфера
	//					}
	//						fileName_F[buffer] = Serial2.read(); 
	//					buffer++;
	//				}
	//			}
=======
			while (Serial2.available())
				{
				  if (overflowFlag)                        // Если буфер переполнен - очистить
					 Serial2.read();
				  else                                     // Размер буфера в норме, считать информацию
					{
					if (buffer_count == BUFFER_SIZEKF)           // Проверить размер буфера
						{
							overflowFlag = 1;              // Установить флаг превышения размера буфера
						}
							fileName_F[buffer_count] = Serial2.read(); 
						buffer_count++;
					}
				}
>>>>>>> .r274
	//	   }
<<<<<<< .mine
	// else 
	//	{
	//
	//	}
	//Serial.println(fileName_F);
	//
=======
	 else 
		{
	
		}

//	int len = readString(buffer, sizeof(buffer), '\r');

	Serial.println(fileName_F);
	*/
>>>>>>> .r274
//	wdt_reset();  // Сброс сторожевого таймера при наличии связи с ПК
}
int readString(char *buffer, int max_len, int terminator)
{
  int pos = 0;

  while (true) {
	if (Serial2.available() > 0) 
	{
	  int readch = Serial2.read();
	  if (readch == terminator) 
	  {
		buffer[pos] = '\0';
		break;
	  }
	  else if (readch != '\n' && pos < max_len-1) 
	  {  // Ignore new-lines
		buffer[pos++] = readch;
		fileName_F[pos++] = readch;
	  }
	}
  }
  return pos;
}

void read_Serial2()
{
	if (Serial2.available())                             // есть что-то проверить? Есть данные в буфере?
		  {
			unsigned char overflowFlag = 0 ;               // Флаг превышения размера буфера
			unsigned char buffer_count = 0;                      // Установить в начало чтения буфера

			while (Serial2.available())
				{
				  if (overflowFlag)                        // Если буфер переполнен - очистить
					 Serial2.read();
				  else                                     // Размер буфера в норме, считать информацию
					{
					if (buffer_count == BUFFER_SIZEKF)           // Проверить размер буфера
						{
							overflowFlag = 1;              // Установить флаг превышения размера буфера
						}
							 bufferSerial2[buffer_count] = Serial2.read(); 
						buffer_count++;
					}
				}
		   }
	 else 
		{
	
		}
	
	for (int i = 0; i < 13; i++)
	{
        fileName_F[i] = bufferSerial2[i];
    }

	Serial.println(bufferSerial2);
	Serial.println(fileName_F);
}

void prer_Kamerton()                                          // Произвести обмен информации с модулем Камертон
{
//	clear_serial1();
	sendPacketK ();  
	// Отправить информацию в модуль Камертон
	waiting_for_replyK();                                  // Получить подтверждение
}
void sendPacketK () 
{              // Программа передачи пакета в Камертон
	calculateCRC_Out();
	for (int i = 0; i <3; i++)
		{
			Serial1.write(regs_out[i]);
			regBank.set(40001+i,regs_out[i]);
		}
}
void waiting_for_replyK()                                  // Чтение данных из Камертона
{
	delayMicroseconds(5);

	//  Уточнить задержку и применение Stop_Kam = 0; 
	if (Serial1.available())                               // есть что-то проверить? Есть данные в буфере?
		  {
			unsigned char overflowFlag = 0 ;               // Флаг превышения размера буфера
			unsigned char buffer = 0;                      // Установить в начало чтения буфера

			while (Serial1.available())
				{
				  if (overflowFlag)                        // Если буфер переполнен - очистить
					 Serial1.read();
				  else                                     // Размер буфера в норме, считать информацию
					{
					if (bufferK == BUFFER_SIZEK)           // Проверить размер буфера
						{
							overflowFlag = 1;              // Установить флаг превышения размера буфера
						}
						 regBank.set(40004+buffer,Serial1.read());
						//regs_in[buffer] = Serial1.read(); 
						buffer++;
					}
				}
//			calculateCRC_In();
			regBank.set(124,1);                              // Связь с "Камертон" установлена
		   }
	 else 
		{
			Stop_Kam = 0;                                    // Флаг отсутств. инф. из Камертона
			regBank.set(124,0);                              // Флаг ошибки  связи с "Камертон"
		}

	  //if( regBank.get(40007) != regs_temp)
	  //{
		 //Serial.println(regBank.get(40004),BIN);
		 //Serial.println(regBank.get(40006),BIN);
		 //Serial.println(regBank.get(40007),BIN);
	  //}
   //   regs_temp = regBank.get(40007);

}
void Stop_Kamerton ()                  //Если не приходит информация с Камертона - регистры обнулить
  {
	 for (unsigned char i = 0; i <4; i++)
	 regBank.set(40004+i,0);
	// regs_in[i]=0;
  }

void calculateCRC_Out()                // Вычисление контрольной суммы ниблов байта
{ 
  byte temp1, temp2, temp3, temp4, crc;
  temp1 = regs_out[1];                 // записать  
  temp1 = temp1&0xF0;                  // Наложить маску F0 на старший нибл 1 байта
  temp2 = temp1>>4;                    // Переместить старший нибл в младший
  temp3 = regs_out[2];                 // записать
  temp3 = temp3&0xF0;                  // Наложить маску F0 на старший нибл 2 байта
  temp3 = temp3>>4;                    // Переместить старший нибл в младший
  temp4 = regs_out[2];                 // записать
  temp4 = temp4&0x0F;                  // Наложить маску F0 на младший нибл 2 байта
  crc =  temp2 ^  temp3 ^  temp4  ;
  crc = crc&0x0F;                      // Наложить маску F0 на младший нибл 2 байта
  regs_out[1]= temp1 | crc;
}
void calculateCRC_In()                 // Вычисление контрольной суммы ниблов байта
{ 
	/*
  byte temp1,temp1H,temp1L, temp2,temp2H,temp2L, temp3,temp3H,temp3L, temp4, temp4H, crc_in;

  temp1 = regs_in[0];                  // записать  
  temp1 = temp1&0xF0;                  // Наложить маску F0 на старший нибл 1 байта
  temp1H = temp1>>4;                   // Переместить старший нибл в младший
  temp1 = regs_in[0];                  // записать 
  temp1L = temp1&0x0F;                 // Наложить маску 0F на младший нибл 1 байта

  temp2 = regs_in[1];                  // записать  
  temp2 = temp2&0xF0;                  // Наложить маску F0 на старший нибл 2 байта
  temp2H = temp2>>4;                   // Переместить старший нибл в младший
  temp2 = regs_in[1];                  // записать 
  temp2L = temp2&0x0F;                 // Наложить маску 0F на младший нибл 2 байта

  temp3 = regs_in[2];                  // записать  
  temp3 = temp3&0xF0;                  // Наложить маску F0 на старший нибл 3 байта
  temp3H = temp3>>4;                   // Переместить старший нибл в младший
  temp3 = regs_in[2];                  // записать 
  temp3L = temp3&0x0F;                 // Наложить маску 0F на младший нибл 3 байта

  temp4 = regs_in[3];                  // записать  
  temp4 = temp4&0xF0;                  // Наложить маску F0 на старший нибл 3 байта
  temp4H = temp4>>4;                   // Переместить старший нибл в младший
  crc_in =   temp1H ^  temp1L  ^   temp2H ^  temp2L  ^  temp3H ^  temp3L  ^  temp4H ;
  crc_in =  crc_in&0x0F;               // Наложить маску F0 на младший нибл 4 байта
  regs_crc[0]= crc_in;
  */
}
void i2c_eeprom_write_byte( int deviceaddress, unsigned int eeaddress, byte data )
{
	int rdata = data;
	Wire.beginTransmission(deviceaddress);
	Wire.write((int)(eeaddress >> 8)); // MSB
	Wire.write((int)(eeaddress & 0xFF)); // LSB
	Wire.write(rdata);
	Wire.endTransmission();
	delay(10);
}
byte i2c_eeprom_read_byte( int deviceaddress, unsigned int eeaddress ) {
	byte rdata = 0xFF;
	Wire.beginTransmission(deviceaddress);
	Wire.write((int)(eeaddress >> 8)); // MSB
	Wire.write((int)(eeaddress & 0xFF)); // LSB
	Wire.endTransmission();
	Wire.requestFrom(deviceaddress,1);
	if (Wire.available()) rdata = Wire.read();
	return rdata;
}
void i2c_eeprom_read_buffer( int deviceaddress, unsigned int eeaddress, byte *buffer, int length )
{
	
	Wire.beginTransmission(deviceaddress);
	Wire.write((int)(eeaddress >> 8)); // MSB
	Wire.write((int)(eeaddress & 0xFF)); // LSB
	Wire.endTransmission();
	Wire.requestFrom(deviceaddress,length);
	int c = 0;
	for ( c = 0; c < length; c++ )
	if (Wire.available()) buffer[c] = Wire.read();
	
}
void i2c_eeprom_write_page( int deviceaddress, unsigned int eeaddresspage, byte* data, byte length ) 
{
	
	Wire.beginTransmission(deviceaddress);
	Wire.write((int)(eeaddresspage >> 8)); // MSB
	Wire.write((int)(eeaddresspage & 0xFF)); // LSB
	byte c;
	for ( c = 0; c < length; c++)
	Wire.write(data[c]);
	Wire.endTransmission();
	
}

void UpdateRegs()                                        // Обновить регистры
{
	//-----Первый байт ------------
	//-----Установить бит 0
	 while(prer_Kmerton_Run == true){}                  // Ждем окончания получения данных из Камертон
	 boolean set_rele ;
	 prer_Kmerton_On = false;                            // Запретить прерывание Камертон ??
	// reg_Kamerton();                                     // Записать данные из Камертон в    регистры 
		// Подпрограмма переноса данных из регистров на порты вывода
	  //-----Установить бит 0
	 set_rele = regBank.get(1);
	 mcp_Out1.digitalWrite(0, set_rele);                 // Реле RL0 Звук  Звук Mic1p Диспетчер

	 //-----Установить бит 1
	  set_rele = regBank.get(2);
	  mcp_Out1.digitalWrite(1, set_rele);               // Реле RL1 Звук Mic2p  Инструкор

	 //-----Установить бит 2
	  set_rele = regBank.get(3);
	  mcp_Out1.digitalWrite(2, set_rele);               // Реле RL2 Звук Mic3p MTT
  
	 //-----Установить бит 3
	  set_rele = regBank.get(4);
	  mcp_Out1.digitalWrite(3, set_rele);               // Реле RL3 Звук

	 //-----Установить бит 4                            // Реле RL4 XP1 12
	  set_rele = regBank.get(5);
	  mcp_Out1.digitalWrite(4, set_rele);    

	 //-----Установить бит 5
	  set_rele = regBank.get(6);                        // Реле RL5 Звук
	  mcp_Out1.digitalWrite(5, set_rele);              

	 //-----Установить бит 6	 
	  set_rele = regBank.get(7);
	  mcp_Out1.digitalWrite(6, set_rele);              // Реле RL6 Звук

	 //-----Установить бит 7
	  set_rele = regBank.get(8);
	  mcp_Out1.digitalWrite(7, set_rele);              // Реле RL7 Питание платы

	 //---- Второй байт----------
	 //-----Установить бит 8
	  set_rele = regBank.get(9);                        // Реле RL8 Звук на микрофон
	  mcp_Out1.digitalWrite(8, set_rele);    

	 //-----Установить бит 9
	  set_rele = regBank.get(10);
	  mcp_Out1.digitalWrite(9, set_rele);               // Реле RL9 XP1 10

	 //-----Установить бит 10                           // Реле RL10 Включение питания на высоковольтный модуль 
	  set_rele = regBank.get(11);
	  mcp_Out1.digitalWrite(10, set_rele);    


	//-----Установить бит 11                            // Свободен 
	  set_rele = regBank.get(12);
	  mcp_Out1.digitalWrite(11, set_rele);    

	 //-----Установить бит 12
	  set_rele = regBank.get(13);
	  mcp_Out1.digitalWrite(12, set_rele);              // XP8 - 2   sensor Тангента ножная

	 //-----Установить бит 13
	  set_rele = regBank.get(14);
	  mcp_Out1.digitalWrite(13, set_rele);              // XP8 - 1   PTT Тангента ножная

	 //-----Установить бит 14

	  set_rele = regBank.get(15);
	  mcp_Out1.digitalWrite(14, set_rele);              // XS1 - 5   PTT Мик

	  //-----Установить бит 15
	  set_rele = regBank.get(16);
	  mcp_Out1.digitalWrite(15, set_rele);              // XS1 - 6   sensor Мик

	  //  Test 3
	 //-----Первый байт ------------
	 //-----Установить бит 0

	  set_rele = regBank.get(17);
	  mcp_Out2.digitalWrite(0, set_rele);                // J8-12     XP7 4 PTT2   Танг. р.

	 //-----Установить бит 1
	  set_rele = regBank.get(18);
	  mcp_Out2.digitalWrite(1, set_rele);                // XP1 - 20  HangUp  DCD

	 //-----Установить бит 2
	  set_rele = regBank.get(19);
	  mcp_Out2.digitalWrite(2, set_rele);                // J8-11     XP7 2 sensor  Танг. р.
  
	//-----Установить бит 3

	  set_rele = regBank.get(20);
	  mcp_Out2.digitalWrite(3, set_rele);                 // J8-23     XP7 1 PTT1 Танг. р.

	 //-----Установить бит 4
	  set_rele = regBank.get(21);
	  mcp_Out2.digitalWrite(4, set_rele);                 // XP2-2     sensor "Маг." 

	 //-----Установить бит 5

	  set_rele = regBank.get(22);
	  mcp_Out2.digitalWrite(5, set_rele);                  // XP5-3     sensor "ГГC."

	 //-----Установить бит 6
	  set_rele = regBank.get(23);
	  mcp_Out2.digitalWrite(6, set_rele);                  // XP3-3     sensor "ГГ-Радио1."

	 //-----Установить бит 7
	  set_rele = regBank.get(24);
	  mcp_Out2.digitalWrite(7, set_rele);                  // XP4-3     sensor "ГГ-Радио2."

	  // Test 4
	//-----Первый байт ------------
	 //-----Установить бит 8
	  set_rele = regBank.get(25);
	  mcp_Out2.digitalWrite(8, set_rele);                  // XP1- 19 HaSs      флаг подключения трубки  

	  //-----Установить бит 9
	  set_rele = regBank.get(26);
	  mcp_Out2.digitalWrite(9, set_rele);                  // XP1- 17 HaSPTT    CTS DSR вкл.

	  //-----Установить бит 10
	  set_rele = regBank.get(27);
	  mcp_Out2.digitalWrite(10, set_rele);                 // XP1- 16 HeS2Rs    флаг подключения гарнитуры инструктора с 2 наушниками

	  //-----Установить бит 11
	  set_rele = regBank.get(28);
	  mcp_Out2.digitalWrite(11, set_rele);                 // XP1- 15 HeS2PTT   CTS вкл

	  //-----Установить бит 12
	  set_rele = regBank.get(29);
	  mcp_Out2.digitalWrite(12, set_rele);                 // XP1- 13 HeS2Ls    флаг подключения гарнитуры инструктора 

	  //-----Установить бит 13
	  set_rele = regBank.get(30);
	  mcp_Out2.digitalWrite(13, set_rele);                 // XP1- 6  HeS1PTT   CTS вкл

	  //-----Установить бит 14
	  set_rele = regBank.get(31);
	  mcp_Out2.digitalWrite(14, set_rele);                 // XP1- 5  HeS1Rs    Флаг подкючения гарнитуры диспетчера с 2 наушниками

	  //-----Установить бит 15
	  set_rele = regBank.get(32);
	  mcp_Out2.digitalWrite(15, set_rele);                 // XP1- 1  HeS1Ls    Флаг подкючения гарнитуры диспетчера

		 if (regBank.get(118)== 0)
		 {
			 test_repeat = false;
		 }
	else
		 {
			test_repeat = true;
		 }


	  //*******************************************************
/*
// перенести состояние регистров в переменные
  
//	  avto_test  =  regBank.get(33);
	 // start_prer =  regBank.get(34);


	  regBank.set(adr_reg_count_cts0, count_test_CTS);                    // записать в регистр показания счетчика проходов теста CTS
	  regBank.set(adr_reg_err_cts0, err_count_cts);                       // записать в регистр показания счетчика ошибок CTS
	  regBank.set(adr_reg_err_volume_HaSPTT, err_count_volume_HaSPTT);    // записать в регистр показания счетчика Нет звука HaSPTT
	  regBank.set(adr_reg_err_HaSPTT_ON, err_count_HaSPTT_ON);            // записать в регистр показания счетчика ошибок HaSPTT_ON
	  regBank.set(adr_reg_err_HaSPTT_OFF, err_count_HaSPTT_OFF);          // записать в регистр показания счетчика ошибок HaSPTT_OFF
	  regBank.set(adr_reg_err_volume_HeS1PTT, err_count_volume_HeS1PTT);  // записать в регистр показания счетчика Нет звука  HeS1PTT
	  regBank.set(adr_reg_err_HeS1PTT_ON, err_count_HeS1PTT_ON);          // записать в регистр показания счетчика ошибок HeS1PTT_ON
	  regBank.set(adr_reg_err_HeS1PTT_OFF,err_count_HeS1PTT_OFF );        // записать в регистр показания счетчика ошибок HeS1PTT_OFF
	  regBank.set(adr_reg_err_volume_HeS2PTT,err_count_volume_HeS2PTT);   // записать в регистр показания счетчика Нет звука HeS2PTT
	  regBank.set(adr_reg_err_HeS2PTT_ON,err_count_HeS2PTT_ON);           // записать в регистр показания счетчика ошибок HeS2PTT_ON     
	  regBank.set(adr_reg_err_HeS2PTT_OFF,err_count_HeS2PTT_OFF);         // записать в регистр показания счетчика ошибок HeS2PTT_OFF
	  regBank.set(adr_reg_err_volume_MicPTT, err_count_volume_MicPTT);    // записать в регистр показания счетчика Нет звука  MicPTT
	  regBank.set(adr_reg_err_MicPTT_ON, err_count_MicPTT_ON);            // записать в регистр показания счетчика ошибок MicPTT_ON
	  regBank.set(adr_reg_err_MicPTT_OFF,err_count_MicPTT_OFF );          // записать в регистр показания счетчика ошибок MicPTT_OFF
	  regBank.set(adr_reg_err_volume_TangNPTT,err_count_volume_TangNPTT); // записать в регистр показания счетчика Нет звука HeS2PTT
	  regBank.set(adr_reg_err_TangNPTT_ON,err_count_TangNPTT_ON);         // записать в регистр показания счетчика ошибок HeS2PTT_ON     
	  regBank.set(adr_reg_err_TangNPTT_OFF,err_count_TangNPTT_OFF);       // записать в регистр показания счетчика ошибок HeS2PTT_OFF

	 // regBank.set(adr_reg_count_Mic, count_test_Mic);                   // записать в регистр показания счетчика проходов теста Mic
	  regBank.set(adr_reg_err_Mic, err_count_Mic);                        // записать в регистр показания счетчика ошибок CTS
	  */
	regBank.set(adr_reg_ind_CTS, !mcp_Analog.digitalRead(CTS));
	regBank.set(adr_reg_ind_DSR, !mcp_Analog.digitalRead(DSR));
	regBank.set(adr_reg_ind_DCD, !mcp_Analog.digitalRead(DCD));

	  time_control();
	  prer_Kmerton_On = true;
}
void Reg_count_clear()
{
	for(unsigned int i = 40200; i<=40319;i++)
	{
		regBank.set(i,0);
	}
		for(unsigned int i = 40400; i<=40519;i++)
	{
		regBank.set(i,0);
	}
	for(int k = 200; k<=319;k++)
	{
		regBank.set(k,false);
	}
	regBank.set(40121,0);
	regBank.set(adr_control_command,0);
}
void set_clock()
{    
		int day    = regBank.get(adr_set_kontrol_day);  
		int month  = regBank.get(adr_set_kontrol_month);          
		int year   = regBank.get(adr_set_kontrol_year);  
		int hour   = regBank.get(adr_set_kontrol_hour);  
		int minute = regBank.get(adr_set_kontrol_minute);  
		int second = 0;
		DateTime set_time = DateTime(year, month, day, hour, minute, second); // Занести данные о времени в строку "set_time"
		RTC.adjust(set_time);                                                 // Записать время в контроллер часов  
		regBank.set(adr_set_time, 0);                                         // Записать в регистр признак окончания выполнения команды
		regBank.set(adr_control_command,0);
}
void data_clock_exchange()
{
	/*
	DateTime now = RTC.now();
	uint16_t year_temp = now.year()-2000;
	uint8_t day_temp = now.day();
	uint8_t mon_temp = now.month();

	byte  b = i2c_eeprom_read_byte(0x50, adr_temp_day);                             //access an address from the memory
		delay(10);

		if (b != day_temp)
			{
				i2c_eeprom_write_byte(0x50, adr_temp_day, day_temp);
				i2c_eeprom_write_byte(0x50, adr_file_name_count,0);                 // при смене даты счетчик номера файла сбросить в "0"
			}
		  regBank.set(adr_reg_temp_day,day_temp);  
		  b = i2c_eeprom_read_byte(0x50, adr_temp_mon);                             //access an address from the memory
		  delay(10);

		if (b!= mon_temp)
			{
				i2c_eeprom_write_byte(0x50, adr_temp_mon,mon_temp);
				i2c_eeprom_write_byte(0x50, adr_file_name_count,0);                 // при смене даты счетчик номера файла сбросить в "0"
			}
		  regBank.set(adr_reg_temp_mon,mon_temp); 
		  b = i2c_eeprom_read_byte(0x50, adr_temp_year);                            //access an address from the memory
		  delay(10);


		if (b!= year_temp)
			{
				i2c_eeprom_write_byte(0x50, adr_temp_year,year_temp);
				i2c_eeprom_write_byte(0x50, adr_file_name_count,0);                 // при смене даты счетчик номера файла сбросить в "0"
			}
		 regBank.set(adr_reg_temp_year,year_temp); 

		  b = i2c_eeprom_read_byte(0x50, adr_file_name_count);                             //access an address from the memory
		  regBank.set(adr_reg_file_name,b);                                                // Регистр  хранения переменной номер файла
		  */
}
void time_control() // Программа записи текущего времени в регистры для передачи в ПК
{
	DateTime now = RTC.now();
	regBank.set(adr_kontrol_day  , now.day());
	regBank.set(adr_kontrol_month, now.month());
	regBank.set(adr_kontrol_year, now.year());
	regBank.set(adr_kontrol_hour, now.hour());
	regBank.set(adr_kontrol_minute, now.minute());
	regBank.set(adr_kontrol_second, now.second());
}
void time_control_get()   // Тестовая программа проверки содержания регистров времени
{
  for (unsigned int i = 0; i < 6; i++)     // 
	{
	   Serial.print(regBank.get(40046+i));   
	   Serial.print(" "); 
	}
Serial.println();   
}

void list_file()
{
 while (file.openNext(sd.vwd(), O_READ))
  {
	file.printName(&Serial);
	Serial.write(' ');
	file.printModifyDateTime(&Serial);
	Serial.write(' ');
	file.printFileSize(&Serial);
	if (file.isDir()) {
	  // Indicate a directory.
	  Serial.write('/');
	}
	Serial.println();
	file.close();
  }
}
void load_list_files()
{
	//wdt_reset();
	if (!sd.begin(chipSelect)) 
		{
			Serial.println("initialization SD failed!");
		}
	else
		{
	
		while (file.openNext(sd.vwd(), O_READ))
		  {
			file.printName(&Serial2);
			Serial2.println();
			file.printName(&Serial);
			Serial.println();
		//	wdt_reset();
			file.close();
		  } 
		   Serial2.flush();
		 }
		delay(1000);
		Serial.println("Files end");
  regBank.set(adr_control_command,0);
}

void file_print_date()  //программа  записи даты в файл
	{
	  DateTime now = RTC.now();
	  myFile.print(now.day(), DEC);
	  myFile.print('/');
	  myFile.print(now.month(), DEC);
	  myFile.print('/');
	  myFile.print(now.year(), DEC);//Serial display time
	  myFile.print(' ');
	  myFile.print(now.hour(), DEC);
	  myFile.print(':');
	  myFile.print(now.minute(), DEC);
	  myFile.print(':');
	  myFile.print(now.second(), DEC);
  }
//void serial_print_date()                           // Печать даты и времени    
//{
//	  DateTime now = RTC.now();
//	  Serial.print(now.day(), DEC);
//	  Serial.print('/');
//	  Serial.print(now.month(), DEC);
//	  Serial.print('/');
//	  Serial.print(now.year(), DEC);//Serial display time
//	  Serial.print(' ');
//	  Serial.print(now.hour(), DEC);
//	  Serial.print(':');
//	  Serial.print(now.minute(), DEC);
//	  Serial.print(':');
//	  Serial.print(now.second(), DEC);
//}
void resistor(int resist, int valresist)
{
	resistance = valresist;
	switch (resist)
	{
	case 1:
			Wire.beginTransmission(address_AD5252);     // transmit to device
			Wire.write(byte(control_word1));            // sends instruction byte  
			Wire.write(resistance);                     // sends potentiometer value byte  
			Wire.endTransmission();                     // stop transmitting
			break;
	case 2:				
			Wire.beginTransmission(address_AD5252);     // transmit to device
			Wire.write(byte(control_word2));            // sends instruction byte  
			Wire.write(resistance);                     // sends potentiometer value byte  
			Wire.endTransmission();                     // stop transmitting
			break;
	}
			//Wire.requestFrom(address_AD5252, 1, true);  // Считать состояние движка резистора 
			//level_resist = Wire.read();                 // sends potentiometer value byte  
}

void controlFileName()
{
  int temp_file_name = 0;
  preob_num_str();
  while (sd.exists(fileName)) 
  {
	if (fileName[BASE_NAME_SIZE + 1] != '9') 
	{
	  fileName[BASE_NAME_SIZE + 1]++;
	}
	else if (fileName[BASE_NAME_SIZE] != '9') 
	{
	  fileName[BASE_NAME_SIZE + 1] = '0';
	  fileName[BASE_NAME_SIZE]++;
	}
	else 
	{
		regBank.set(122,1);                              // Флаг ошибки  открытия файла
	}
  }
 
  temp_file_name = ((fileName[BASE_NAME_SIZE]-48)*10) + (fileName[BASE_NAME_SIZE + 1]-48); // преобразование символьного номера файла в числа
 
  if (temp_file_name == 0)
  {
	 regBank.set(adr_reg_file_name,temp_file_name);   
  }
  else
  {
	  regBank.set(adr_reg_file_name,temp_file_name-1); 
  }

  delay(200);
  regBank.set(adr_control_command,0);  
}
void FileOpen()
{
  int temp_file_name = 0;
  preob_num_str();
  while (sd.exists(fileName)) 
  {
	if (fileName[BASE_NAME_SIZE + 1] != '9') 
	{
	  fileName[BASE_NAME_SIZE + 1]++;
	}
	else if (fileName[BASE_NAME_SIZE] != '9') 
	{
	  fileName[BASE_NAME_SIZE + 1] = '0';
	  fileName[BASE_NAME_SIZE]++;
	}
	else 
	{
		regBank.set(122,1);                              // Флаг ошибки  открытия файла
	}
  }

 
  temp_file_name = ((fileName[BASE_NAME_SIZE]-48)*10) + (fileName[BASE_NAME_SIZE + 1]-48); // преобразование символьного номера файла в числа
  regBank.set(adr_reg_file_name,temp_file_name);      
//  i2c_eeprom_write_byte(0x50, adr_file_name_count,temp_file_name);                 // при смене даты счетчик номера файла сбросить в "0"

  if (!myFile.open(fileName, O_CREAT | O_WRITE | O_EXCL)) //sdError("file.open");
  {
	regBank.set(122,1);                              // Флаг ошибки  открытия файла
  }
  else
  {
	Serial.print(fileName);
	Serial.println(F("  Open Ok!"));

	DateTime now = RTC.now();

	regBank.set(adr_Mic_Start_day , now.day());           // Время старта теста
	regBank.set(adr_Mic_Start_month, now.month());
	regBank.set(adr_Mic_Start_year, now.year());
	regBank.set(adr_Mic_Start_hour, now.hour());
	regBank.set(adr_Mic_Start_minute, now.minute());
	regBank.set(adr_Mic_Start_second, now.second());
	// Уточнить 			
	regBank.set(adr_Time_Test_day, 0); 
	regBank.set(adr_Time_Test_hour, 0); 
	regBank.set(adr_Time_Test_minute, 0); 
	regBank.set(adr_Time_Test_second, 0); 
	myFile.println ("");
	myFile.print ("Report of test module Audio-1 N ");
	byte y[4];                                //Чтение из памяти текущих данных счетчика 
		y[3]= regBank.get(40010);
		y[2]= regBank.get(40011);
		y[1]= regBank.get(40012);
		y[0]= regBank.get(40013);
		number_audio = (unsigned long&) y;       // Сложить восстановленные текущие данные в count_colwater_old
	myFile.print (number_audio);
	myFile.println ("");
	myFile.println ("");
	myFile.println ("");
	myFile.print ("Start test   ");
	file_print_date();
	myFile.println ("");
	regBank.set(122,0);                              // Флаг индикации открытия файла                                   
	delay(100);
   }
  regBank.set(adr_control_command,0);  
}
void FileClose()
{
	
	myFile.println ("");
	myFile.print ("Stop test   ");
	file_print_date();
	myFile.println ("");
	myFile.close();

	if (sd.exists(fileName))
		{ 
			Serial.println();
			Serial.print(fileName);
			Serial.println("  Close  OK!.");
			regBank.set(123,0);                                  // Флаг закрытия файла
		}
	else 
		{
			Serial.println();
			Serial.print(fileName);
			Serial.println(" doesn't exist.");  
			regBank.set(123,1);                              // Флаг ошибки  закрытия файла
		}
	regBank.set(adr_control_command,0);                                             // Завершить программу    
	delay(100);
}

void file_name()
{

   preob_num_str();

  while (sd.exists(fileName)) 
  {
	if (fileName[BASE_NAME_SIZE + 1] != '9') 
	{
	  fileName[BASE_NAME_SIZE + 1]++;
	}
	else if (fileName[BASE_NAME_SIZE] != '9') 
	{
	  fileName[BASE_NAME_SIZE + 1] = '0';
	  fileName[BASE_NAME_SIZE]++;
	}
	else 
	{
		Serial.println("Can't create file name");
//	  sdError("Can't create file name");
	}
  }
  if (!myFile.open(fileName, O_CREAT | O_WRITE | O_EXCL)) //sdError("file.open");
  {
  }
  Serial.print(F("Logging to: "));
  Serial.println(fileName);
  myFile.close();
  Serial.println("done.");
 } 
void preob_num_str() // Программа формирования имени файла, состоящего из текущей даты и счетчика файлов
{
	DateTime now = RTC.now();
	day   = now.day();
	month = now.month();
	year  = now.year();
	int year_temp = year-2000;
	itoa (year_temp,str_year_file, 10);                                        // Преобразование даты год в строку ( 10 - десятичный формат) 

	if (month <10)
		{
		   itoa (0,str_mon_file0, 10);                                         //  Преобразование даты месяц  в строку ( 10 - десятичный формат) 
		   itoa (month,str_mon_file10, 10);                                    //  Преобразование числа в строку ( 10 - десятичный формат) 
		   sprintf(str_mon_file, "%s%s", str_mon_file0, str_mon_file10);       // Сложение 2 строк
		}
	else
		{
		   itoa (month,str_mon_file, 10);                                      // Преобразование числа в строку ( 10 - десятичный формат) 
		}
	if (day <10)
		{
		   itoa (0,str_day_file0, 10);                                         // Преобразование числа в строку ( 10 - десятичный формат) 
		   itoa (day,str_day_file10, 10);                                      // Преобразование числа в строку ( 10 - десятичный формат) 
		   sprintf(str_day_file, "%s%s", str_day_file0, str_day_file10);       // Сложение 2 строк
		}
	else
		{
		itoa (day,str_day_file, 10);                                           // Преобразование числа в строку ( 10 - десятичный формат) 
		}
		 
	sprintf(str1, "%s%s",str_year_file, str_mon_file);                         // Сложение 2 строк
	sprintf(str2, "%s%s",str1, str_day_file);                                  // Сложение 2 строк
	sprintf(fileName, "%s%s", str2, "00.TXT");                                 // Получение имени файла в file_name
	//Serial.println(fileName);
	regBank.set(adr_reg_temp_day, day);  
	regBank.set(adr_reg_temp_mon, month); 
	regBank.set(adr_reg_temp_year, year-2000); 
	//char* strcpy(char* fileName_p, const char* fileName);
	//Serial.println(fileName_p);
}

void control_command()
{
	/*
	Для вызова подпрограммы проверки необходимо записать номер проверки по адресу adr_control_command (40120) 
	Код проверки
	0 -  Выполнение команды окончено
	1 -  Отключить все сенсоры
	2 -  Включить все сенсоры
	3 -  Тест Инструктора
	4 -  Тест диспетчера
	5 -  Тест МТТ
	6 -  Тест Танг.р
	7 -  Тест Микрофон
	8 -  Тест ГГС
	9 -  Тест Радио 1
	10 - Тест Радио 2
	11 - Тест Магнитофон
	12 - Открыть файл
	13 - Закрыть файл
	14 - Записать время
	15 - Установить уровень сигнала
	16 - Reg_count_clear();			                                        // Сброс счетчиков ошибок                    
	17 - test_power();                                                    	// Проверить напряжение  питания
	18 - set_video();				 //
	19 - test_video();				 //
	20 - Записать уровни порогов заводские
	21 - Записать уровни порогов пользовательские
	22 - Получить уровни порогов пользовательские
	23 - Контроль имени файла
	*/
	UpdateRegs() ;

	int test_n = regBank.get(adr_control_command);                                  //адрес  40120
	if (test_n != 0)
	{
//	Serial.println(test_n);	
	switch (test_n)
	{
		case 1:
			 sensor_all_off();                                                      // Отключить все сенсоры
			 wdt_reset();
			 break;
		case 2:		
			 sensor_all_on();                                                       // Включить все сенсоры
			 wdt_reset();
			 break;
		case 3:
			 test_headset_instructor();
			 wdt_reset();
			 break;
		case 4:	
			 test_headset_dispatcher();                                             //
			 wdt_reset();
			 break;
		case 5:
			 test_MTT();                                                            //
			 wdt_reset();
			 break;
		case 6:	
			 test_tangR();                                                          //
			 wdt_reset();
			 break;
		case 7:
			test_tangN();
			wdt_reset();
			break;
		case 8:				
			 testGGS();
			 wdt_reset();
			 break;
		case 9:
			 test_GG_Radio1();
			 wdt_reset();
			 break;
		case 10:	
			 test_GG_Radio2();
			 wdt_reset();
			 break;
		case 11:				
			 test_mikrophon();                                                      // Тестирование микрофона
			 wdt_reset();
			 break;
		case 12:
			   FileOpen();
			  wdt_reset();
			  break;
		case 13:
		
			  FileClose();
			  wdt_reset();
			  break;
		case 14:
			  set_clock();
				break;
		case 15:
			  set_rezistor();
				break;
		case 16:
				Reg_count_clear();			                                        // Сброс счетчиков ошибок                    
				break;
		case 17:
				test_power();                                                    	// Проверить напряжение  питания
				wdt_reset();
				break;
		case 18:
				set_video();				              //
				
				break;
		case 19:
				test_video();				              //
				break;
		case 20:                                           // Записать уровни порогов заводские
				default_mem_porog();
				break;
		case 21:                                           // 	21 - Записать уровни порогов пользовательские
				set_mem_porog();
				break;
		case 22:                                           // 22 - Получить уровни порогов пользовательские
				read_mem_porog();
				break;
		case 23:   
				controlFileName();                         // Контроль имени файла
				break;
		case 24:   
				 set_SD();                                 // Проверка SD памяти
				break;
		case 25:   
			 //   Serial.println(test_n);	
			    readFileName();
				send_file_PC();                                 // 
				break;
		case 26:   
				load_list_files();  
				break;
		case 27:   
				file_del_SD();
				break;
		 case 28:   
				test_RS232();
				break;
		
		default:

			wdt_reset();
		break;
	 }
	 wdt_reset();
	 regBank.set(adr_control_command,0);
	}
}
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
void loop()
{
	control_command();

//	delay(100);
	/*
	 Serial.print(regs_out[0],HEX);
	 Serial.print("--");
	 Serial.print(regs_out[1],HEX);
	 Serial.print("--");
	 Serial.print(regs_out[2],HEX);
	 Serial.print("    ");
	 */
	 //Serial.print(regBank.get(40004),HEX); 
	 //Serial.print("--");
	 //Serial.print(regBank.get(40005),HEX); 
	 //Serial.print("--");
	 //Serial.print(regBank.get(40006),HEX); 
	 //Serial.print("--");
	 //Serial.println(regBank.get(40007),HEX); 

	//Serial.print(	regBank.get(136),HEX);    // XP1- 16 HeS2Rs    sensor подключения гарнитуры инструктора с 2 наушниками
	//Serial.print("--");
	//Serial.println(	regBank.get(137),HEX);    // XP1- 13 HeS2Ls    sensor подключения гарнитуры инструктора 
 
}
